raymirabel/ArduPLC/ArduPLCm/README.md

# ArduPLCm #
### Pequeño dispositivo basado en Arduino pensado para sistemas de control y entornos industriales ###

----------

ArduPLCm es un dispositivo microcontrolador que nos ofrece la posibilidad de conectar y controlar dispositivos eléctricos o electrónicos directamente sin necesidad de componentes adicionales. Básicamente es un Arduino con posibilidad real de control.

Gracias a su puerto RS485, está recomendado para aplicaciones distribuidas como domótica, conexión con PLCs industriales, control, etc.

Todas las entradas y salidas son accesibles a través de robustas bornas de tornillo.

ArduPLCm se entrega montado en una caja estándar para carril DIN. Esto nos facilita el montaje dentro de cuadros eléctricos para automatización, domótica, etc.

Para que no pierdas tiempo, hemos incluido en la sección de descargas un nuevo skech que **convierte a tu ArduPLCm en esclavo Modbus RTU**.

**Optiboot_ArduPLCm** es un bootloader de optiboot modificado para ArduPLCm. Este bootloader evita estados indeseados en las salidas de reles cuando ArduPLCm se alimenta.

Características:

- Microcontrolador Atmel ATmega328.
- 4 relés de salida.
- 4 entradas digitales.
- 4 entradas analógicas.
- Dipswitch 6 posiciones.
- Puerto de comunicaciones RS485.
- Programación por ICSP o conector serie TTL.
- Amplio rango de alimentación de6.5 a30 voltios.
- Regulador conmutado.
- Compatible con Arduino.
- Caja para carril DIN.

Especificaciones técnicas:

- Rango de alimentación: 6.5 a30 VDC
- Protección de alimentación: inversión de polaridad
- Protecciones de sobretensión en: entradas analógicas y puerto RS485
- Consumo a 24VDC en reposo: 10mA (0.24W)
- Consumo a 24VDC máximo: 80mA (1.92W)
- Rango entradas analógicas: 0 a 5 VDC
- Rango entradas digitales: 0 a 5VDC
- Máxima corriente salidas relé: 10A
- Máxima tensión salidas relé: 250VAC o 30VDC
- Máxima potencia salidas relé: 2500VA, 300W
- Puerto RS485: No aislado, ¼ unidad de carga, protección ESD +/- 15Kv, control automático de dirección de datos
- Temperatura de funcionamiento: -40 a 85 ºC
- Ancho: 87 mm
- Alto: 90 mm
- Fondo: 58 mm
- Peso: 150 g.
