raymirabel/ArduPLC/ArduPLC V2/Examples/test_ArduPLC_v2_00/Cambiar SS_PIN.txt

Editar el fichero Sd2PinMap.h dentro de la libreria SD/utility
Cambiar:

//------------------------------------------------------------------------------
#else  // defined(__AVR_ATmega1280__) || defined(__AVR_ATmega2560__)
// 168 and 328 Arduinos

// Two Wire (aka I2C) ports
uint8_t const SDA_PIN = 18;
uint8_t const SCL_PIN = 19;

// SPI port
//uint8_t const SS_PIN = 10;
uint8_t const SS_PIN = 2;
uint8_t const MOSI_PIN = 11;
uint8_t const MISO_PIN = 12;
uint8_t const SCK_PIN = 13;
