raymirabel/ArduPLC/ArduPLC V2/ArduPLC V2 - Schematic.pdf

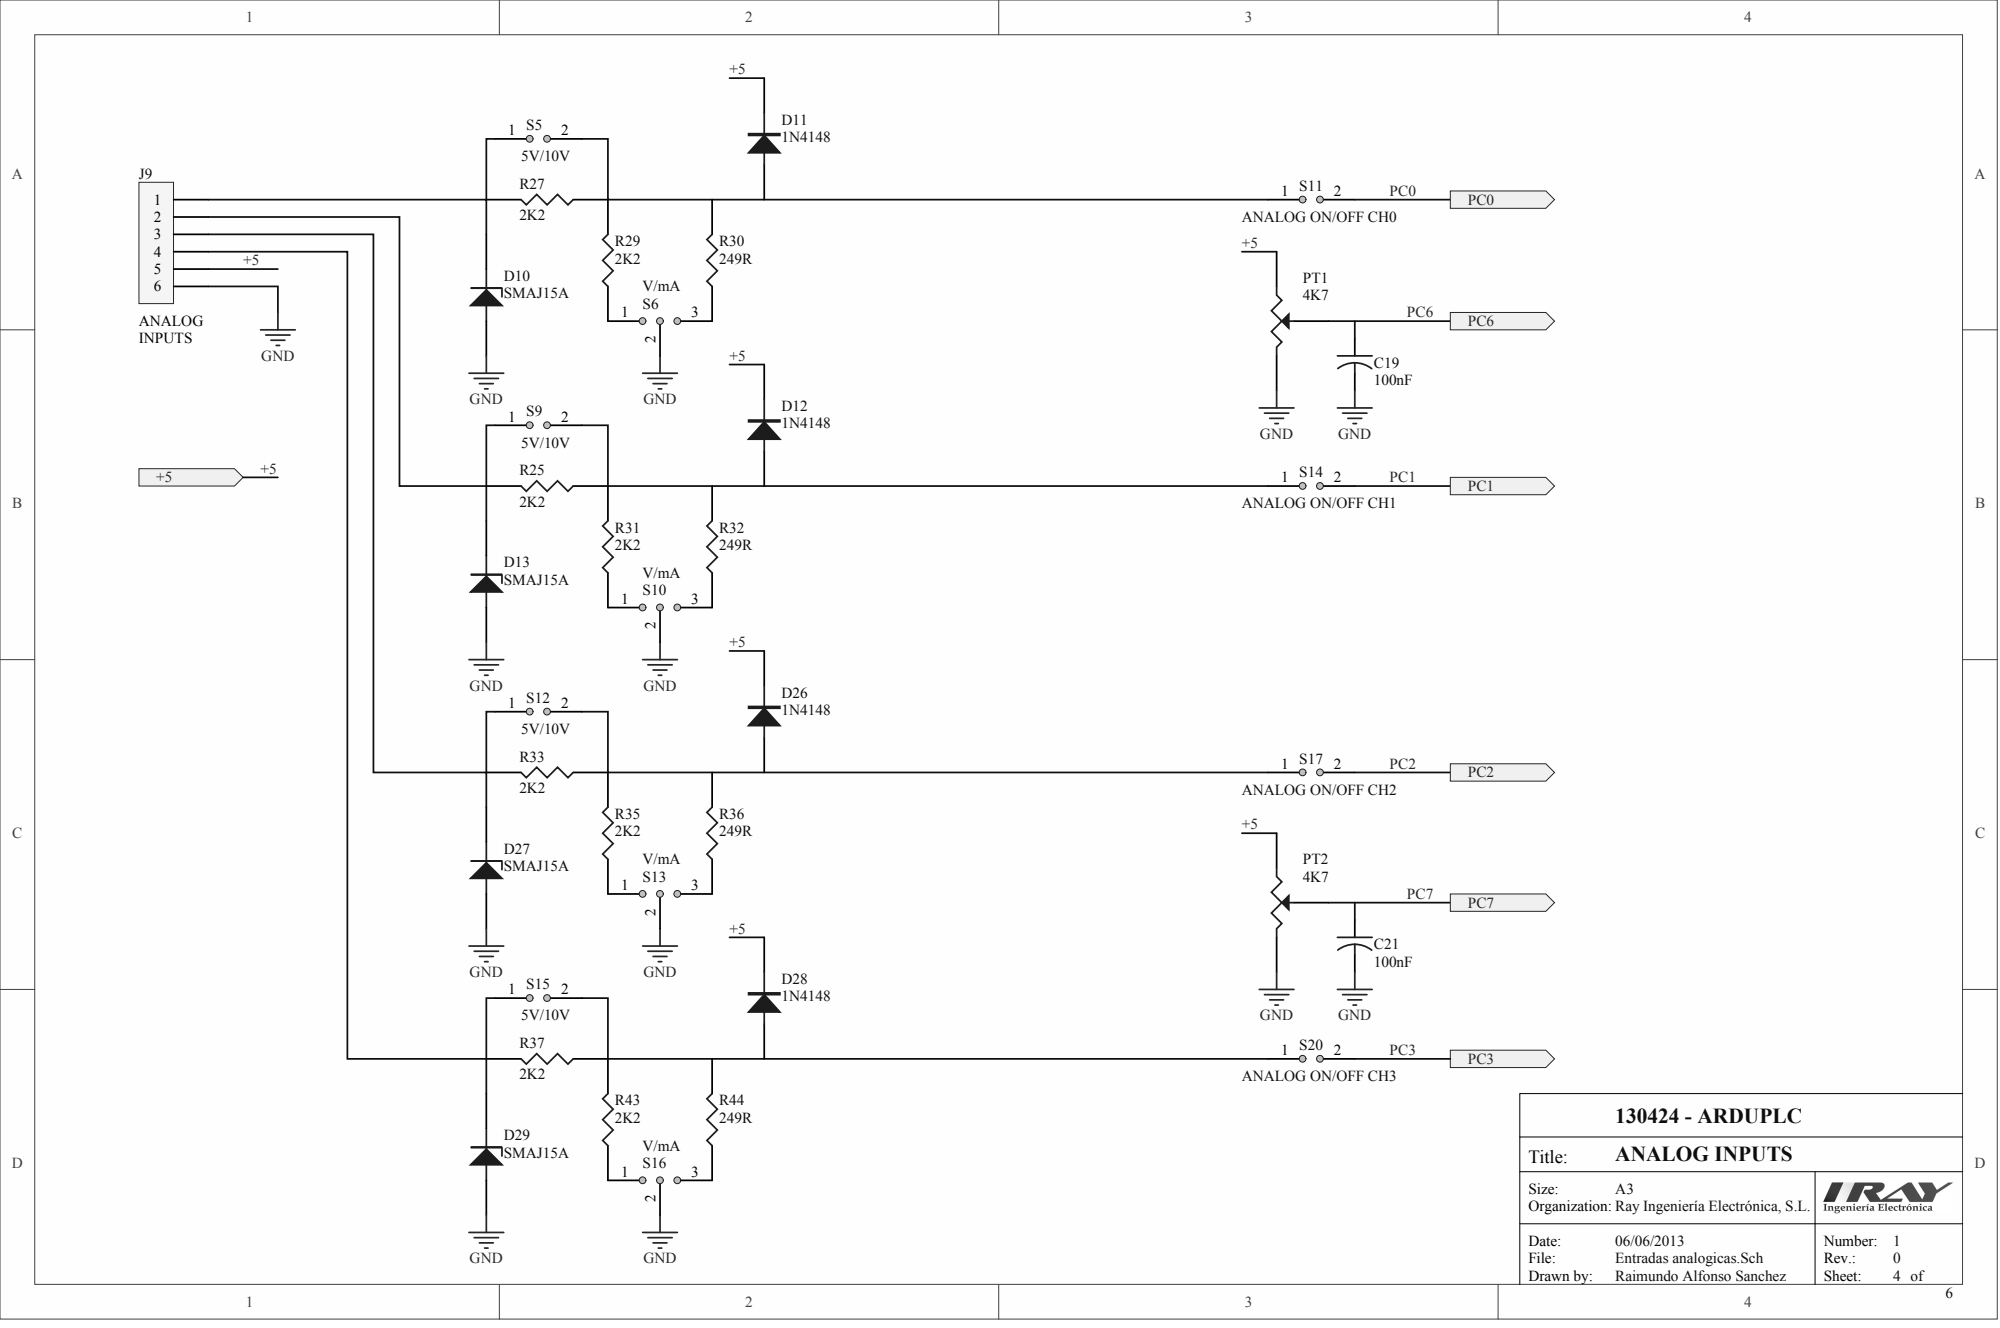
[picture p99: page 1]

P0J903
P0J905 | +5

Size: A3 Organization: Ray Ingeniería Electrónica, S.L .

Date: File: 06/06/2013 Entradas analogicas.Sch Drawn by : Raimundo Alfonso Sanchez | Number: 41 Rev.: 0 Sheet: of

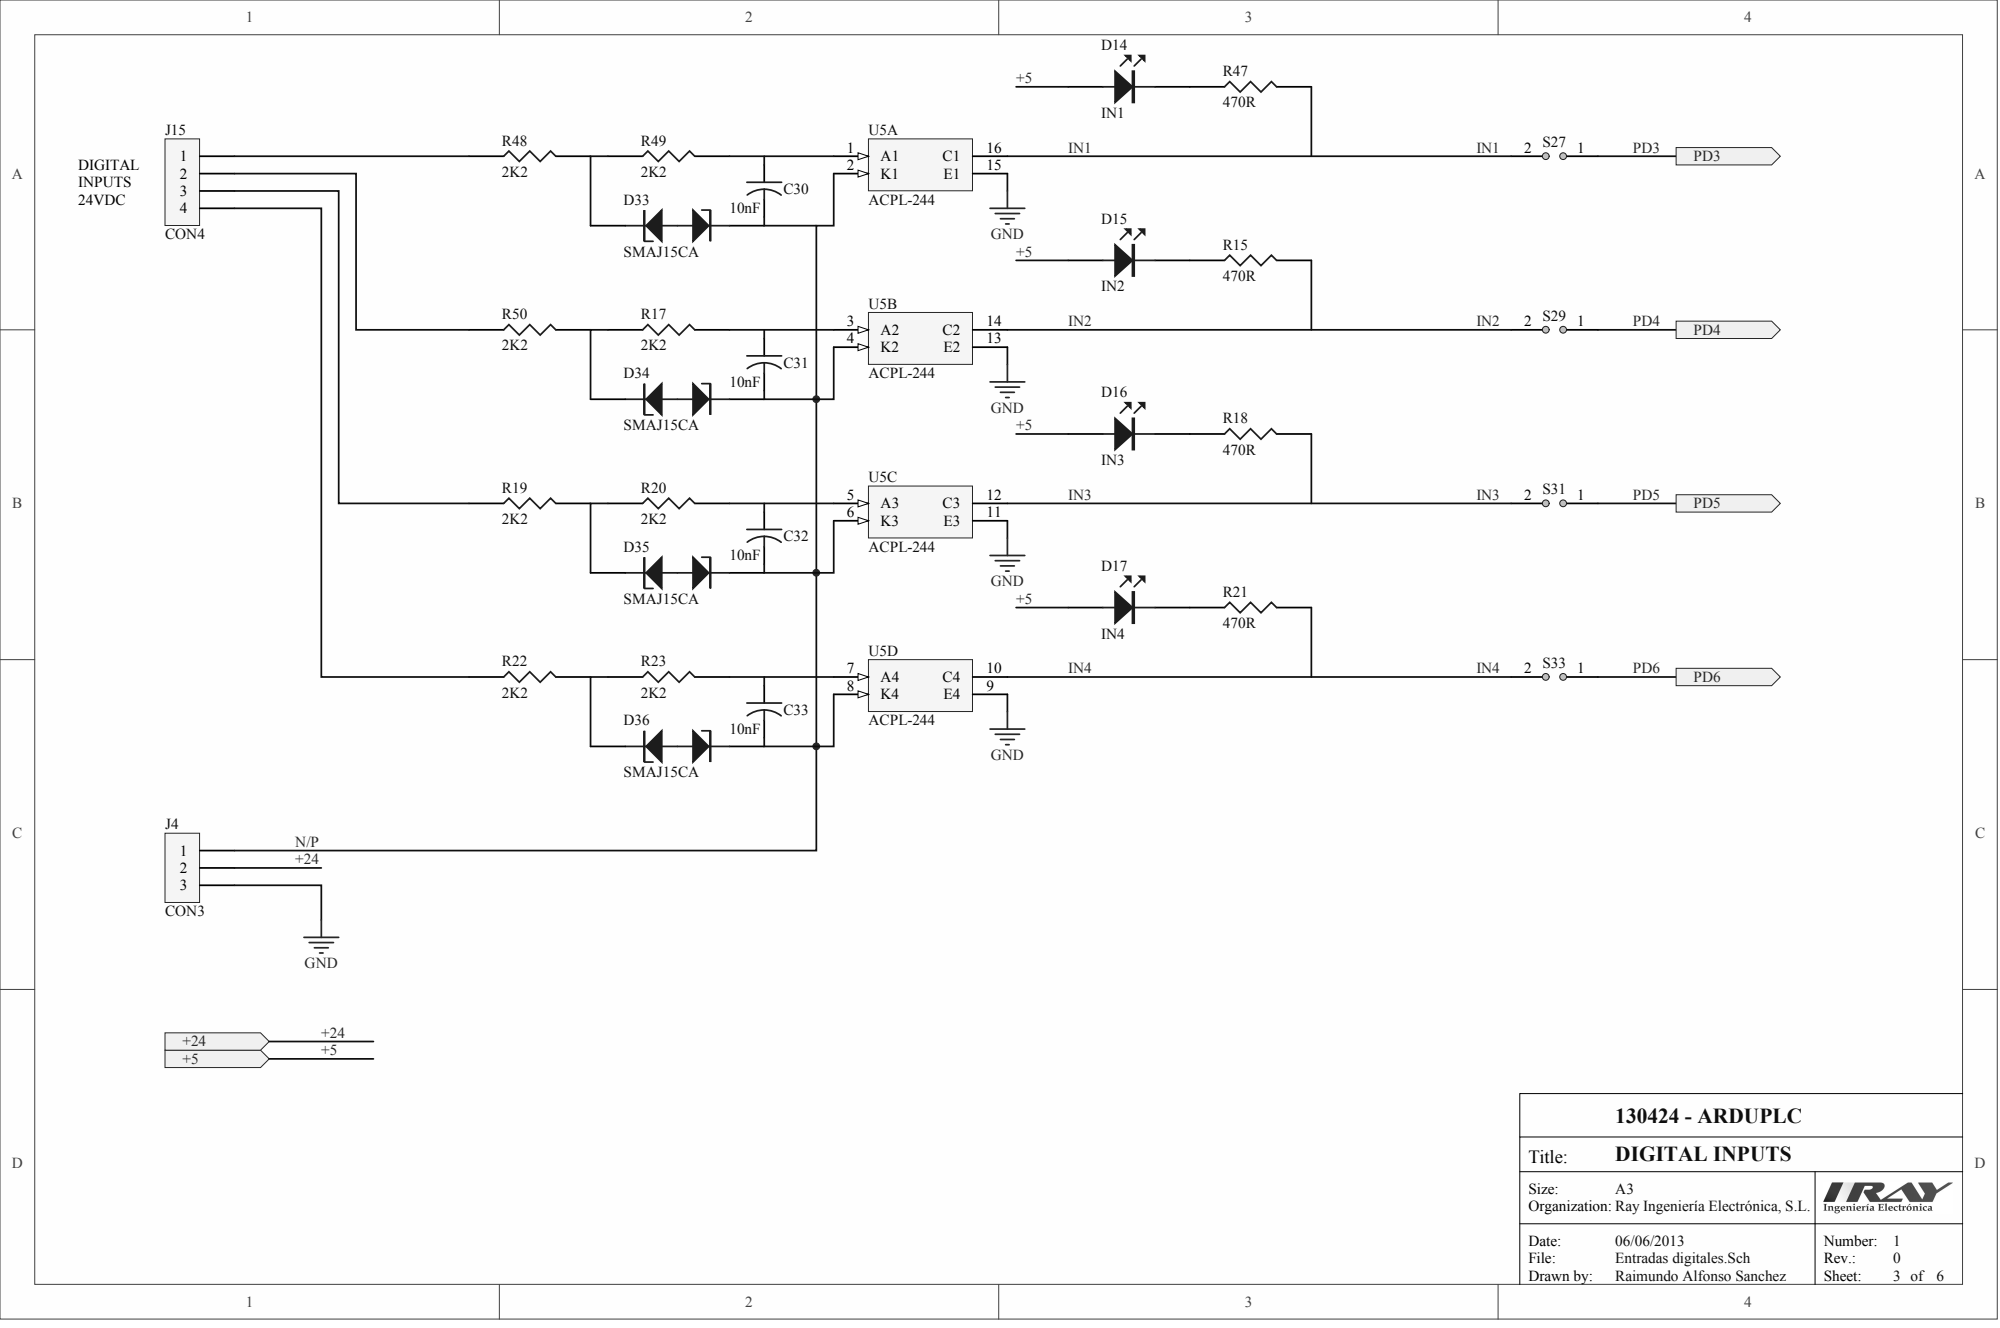
[picture p100: page 2]

Size: A3 Organization: Ray Ingeniería Electrónica, S.L .

Date: File: 06/06/2013 Entradas digitales.Sch Drawn by : Raimundo Alfonso Sanchez | Number: 1 Rev.: 03 Sheet: of 6

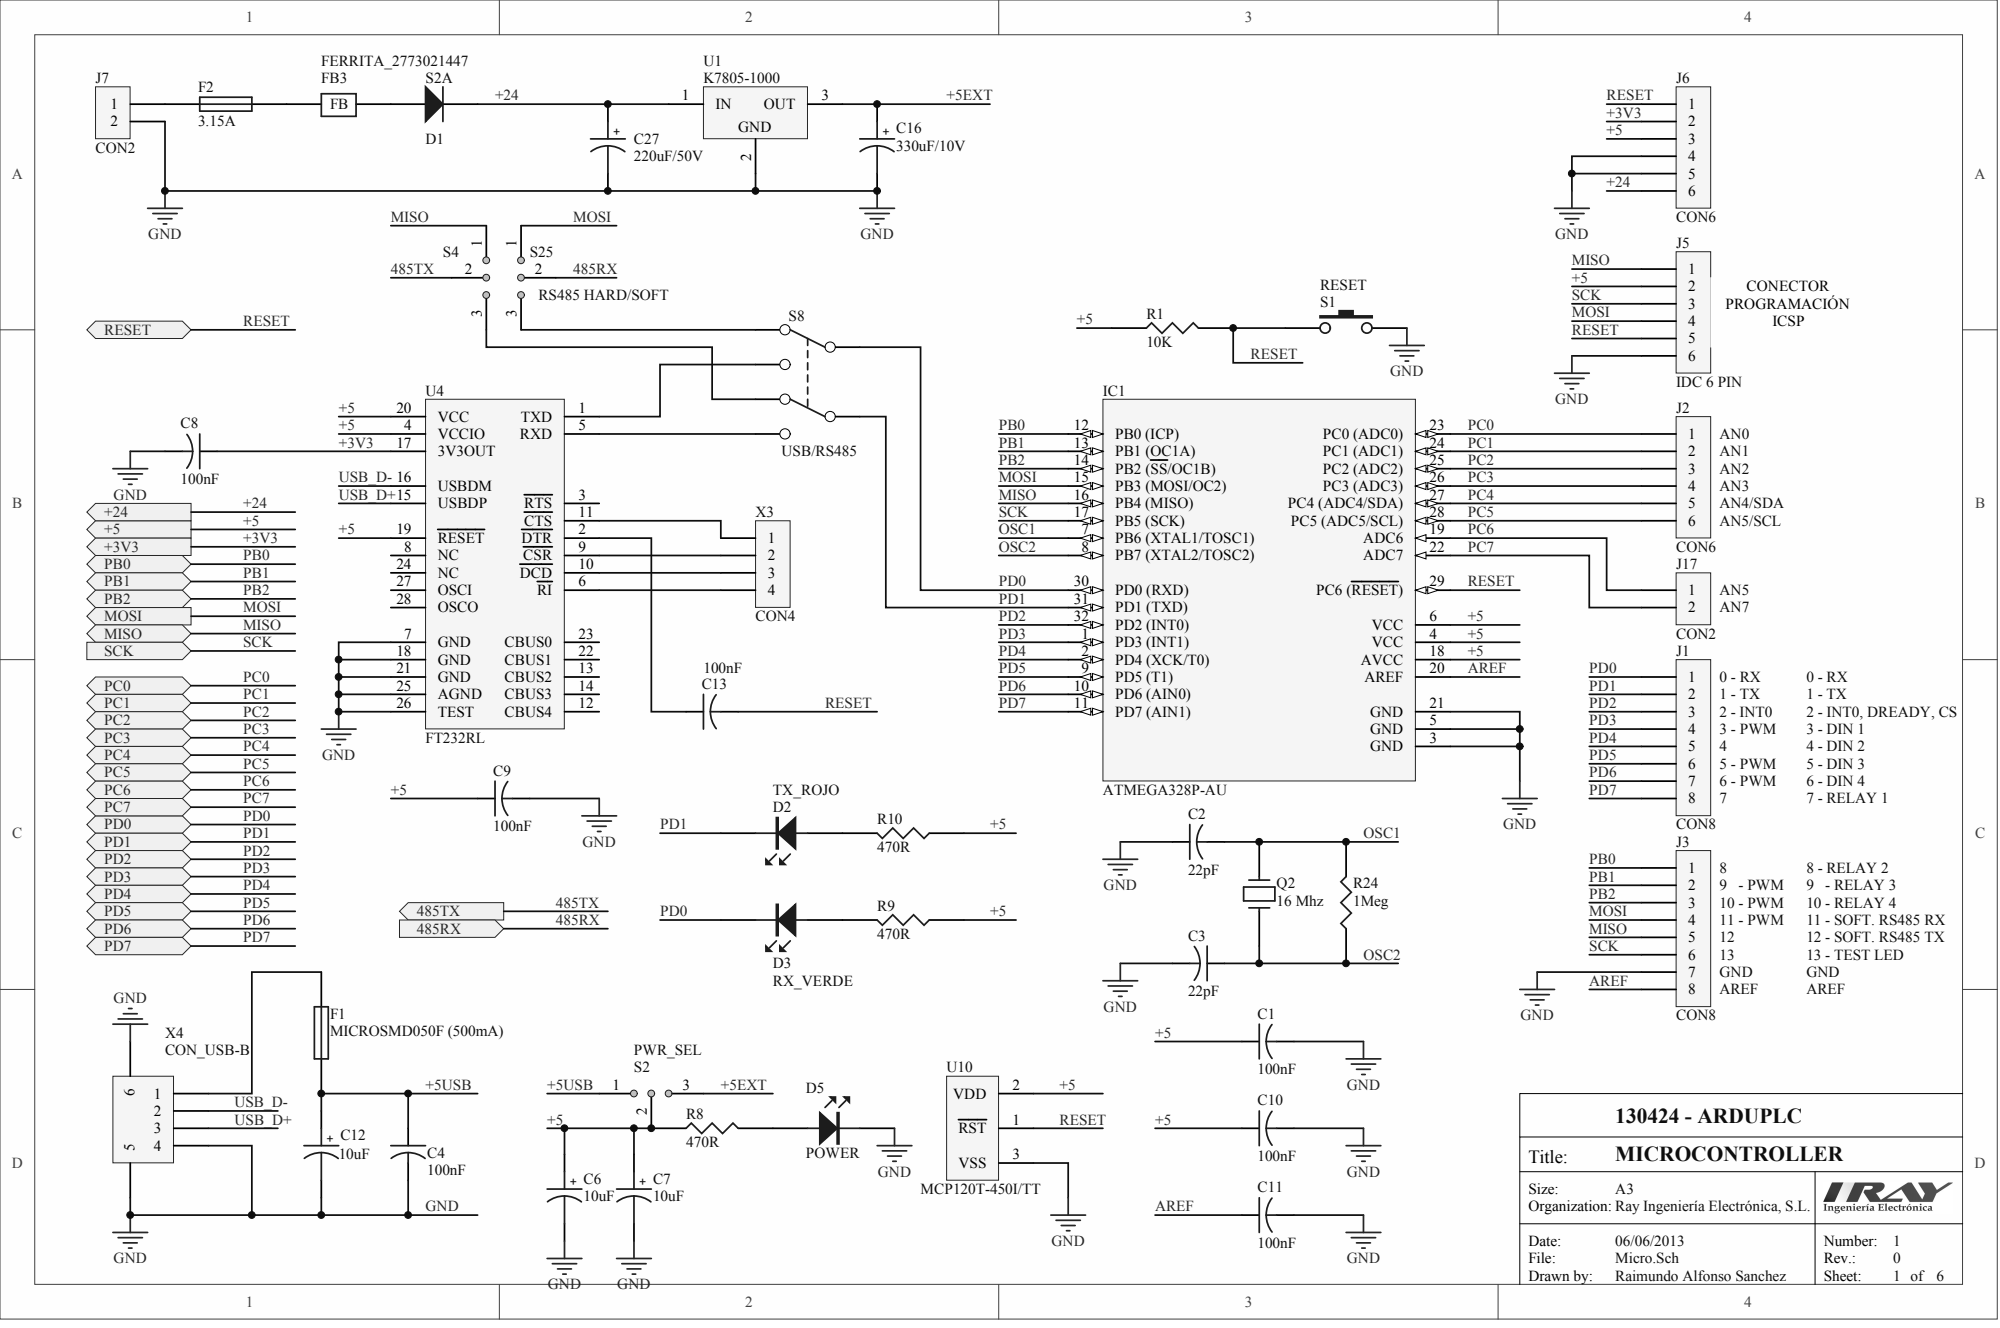
[picture p101: page 3]

Size: A3 Organization: Ray Ingeniería Electrónica, S.L .

Date: File: 06/06/2013 Micro.Sch Drawn by : Raimundo Alfonso Sanchez | Number: 1 Rev.: 01 Sheet: of 6

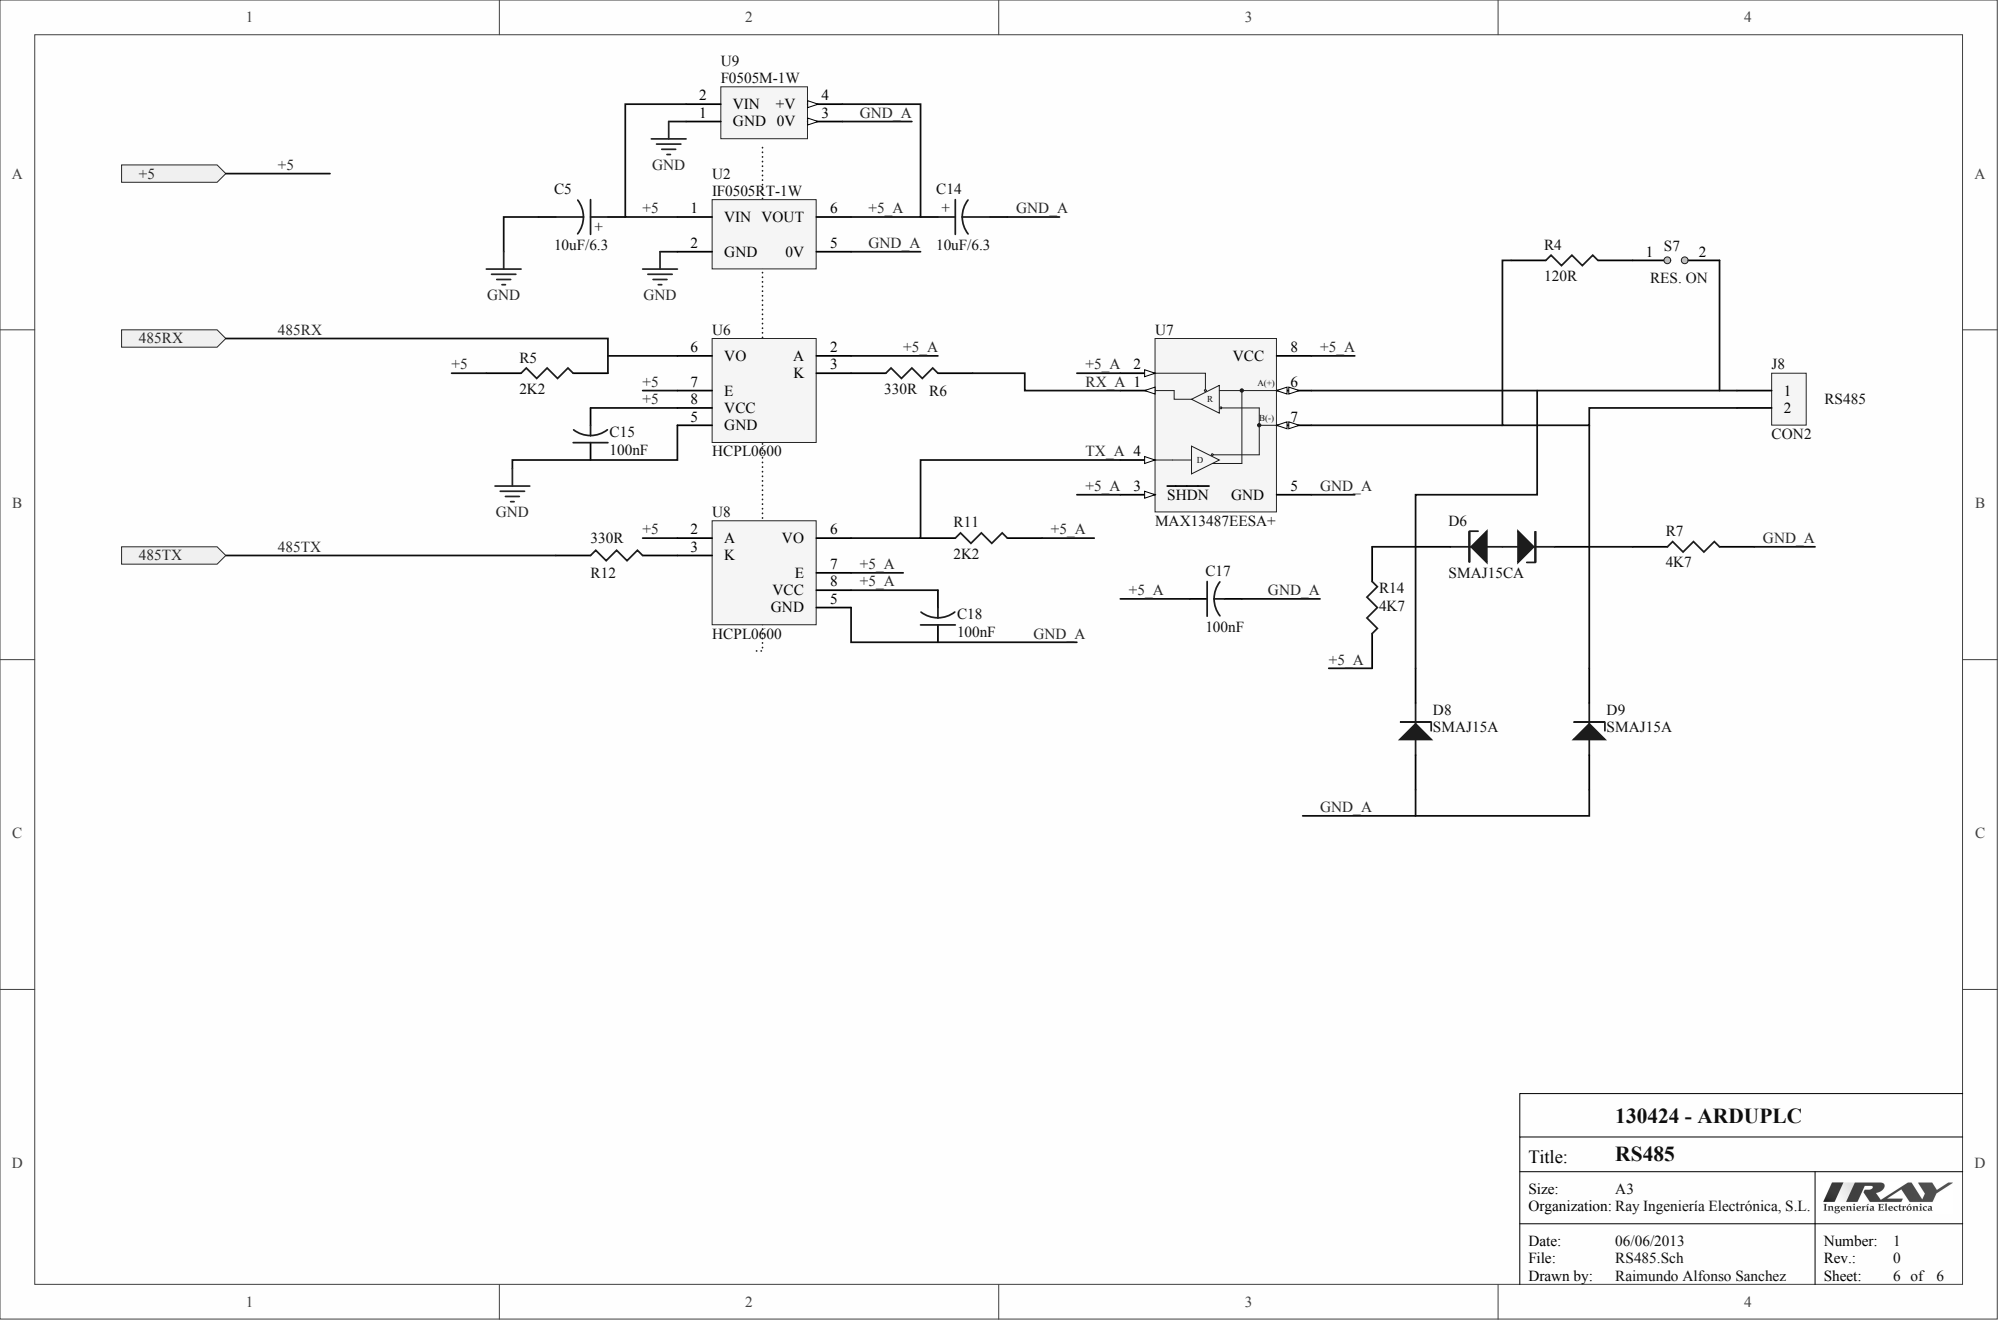
[picture p102: page 4]

Size: A3 Organization: Ray Ingeniería Electrónica, S.L.

Date: 06/06/2013 File: RS485.Sch Drawn by: Raimundo Alfonso Sanchez | Number: 1 Rev.: 0 Sheet: 6 of 6

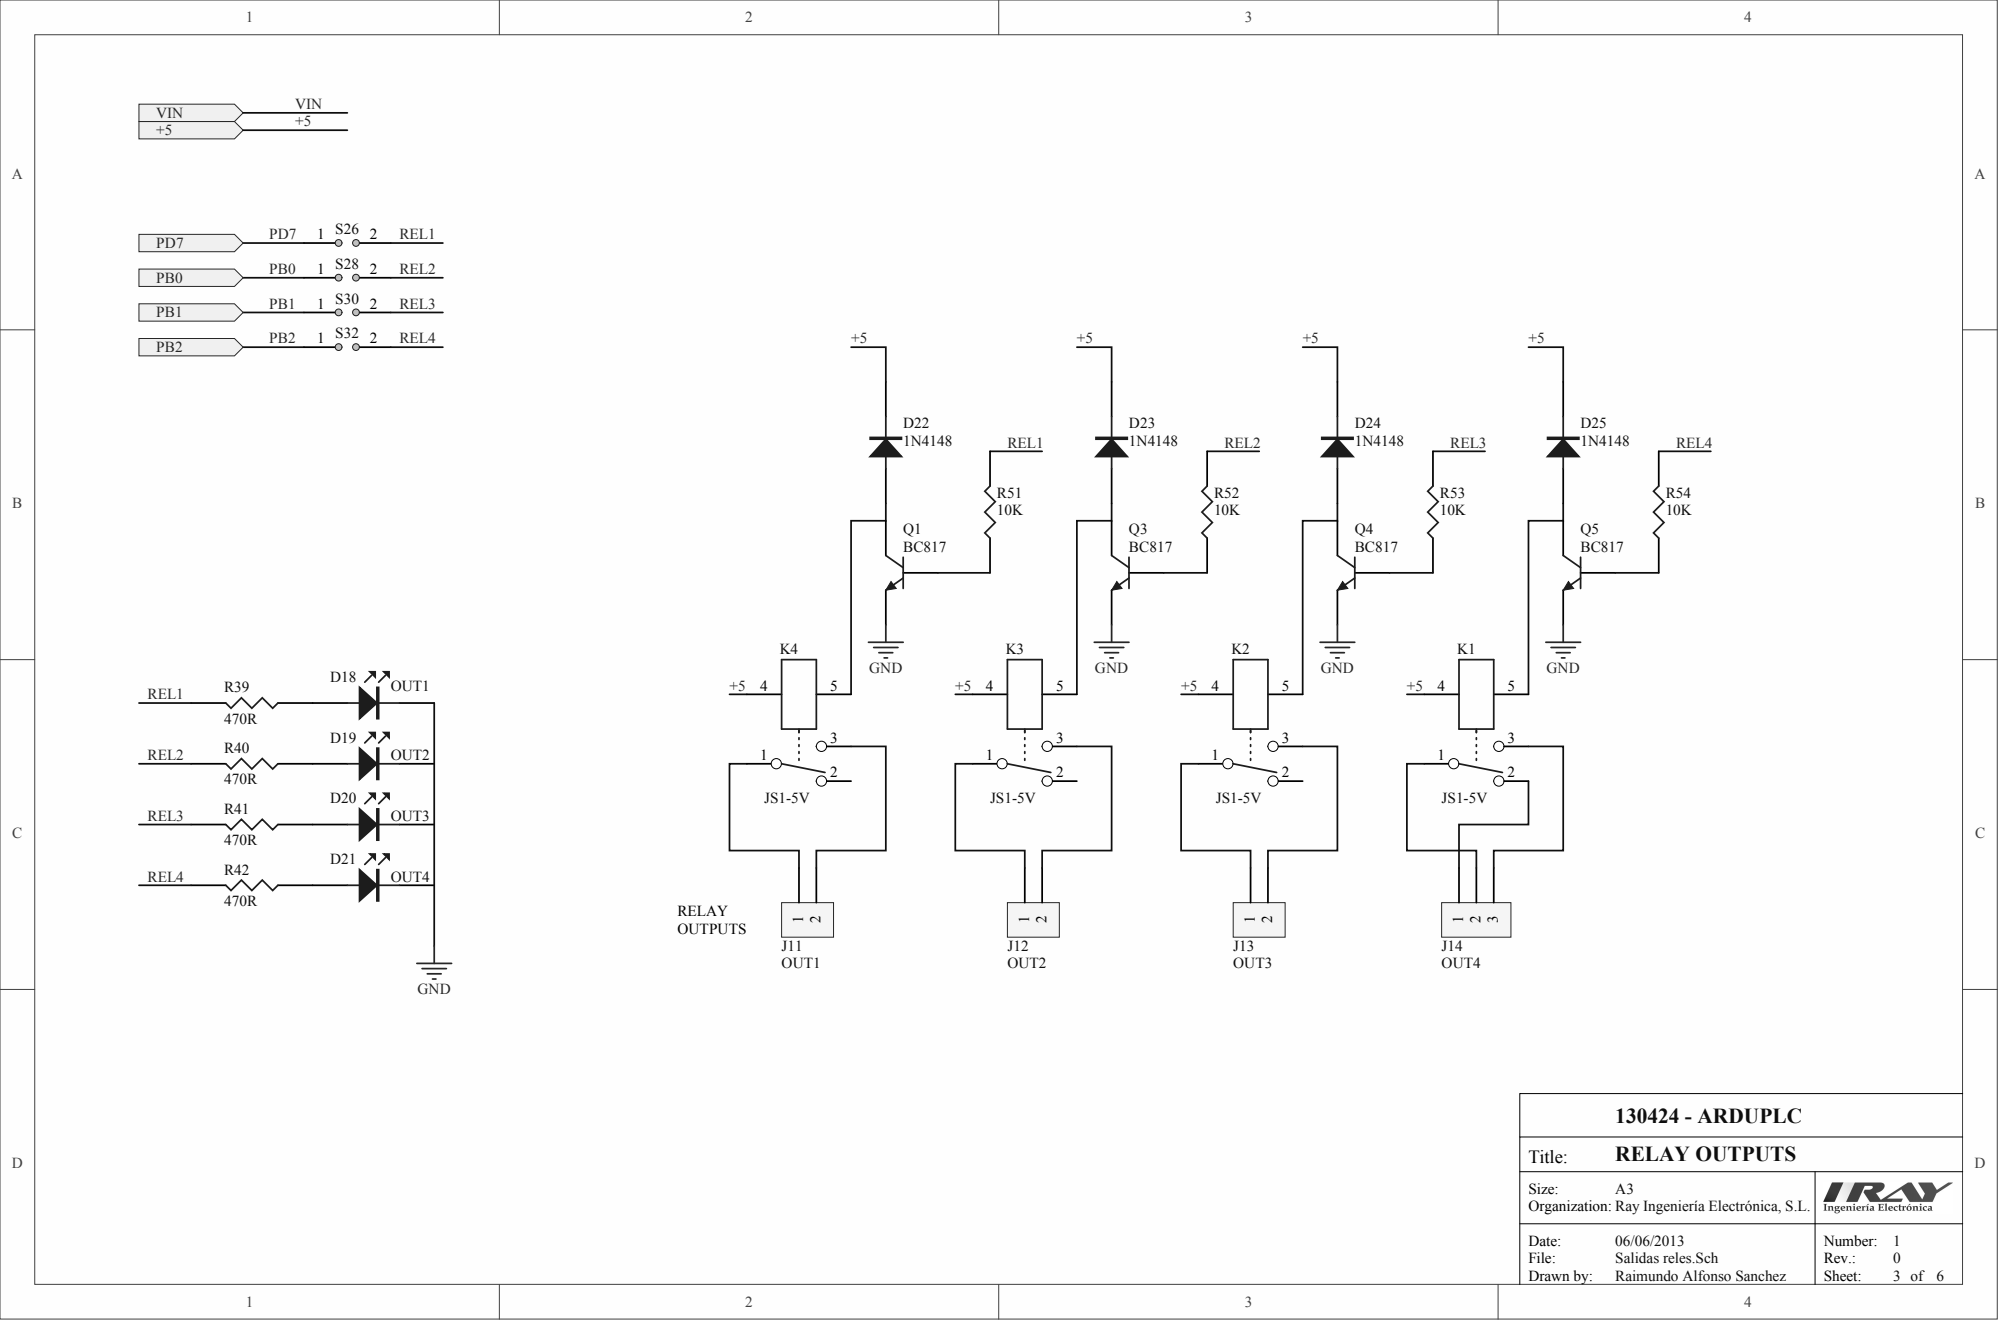
[picture p103: page 5]

Size: A3 Organization: Ray Ingeniería Electrónica, S.L .

Date: File: 06/06/2013 Salidas reles.Sch Drawn by : Raimundo Alfonso Sanchez | Number: 1 Rev.: 03 Sheet: of 6

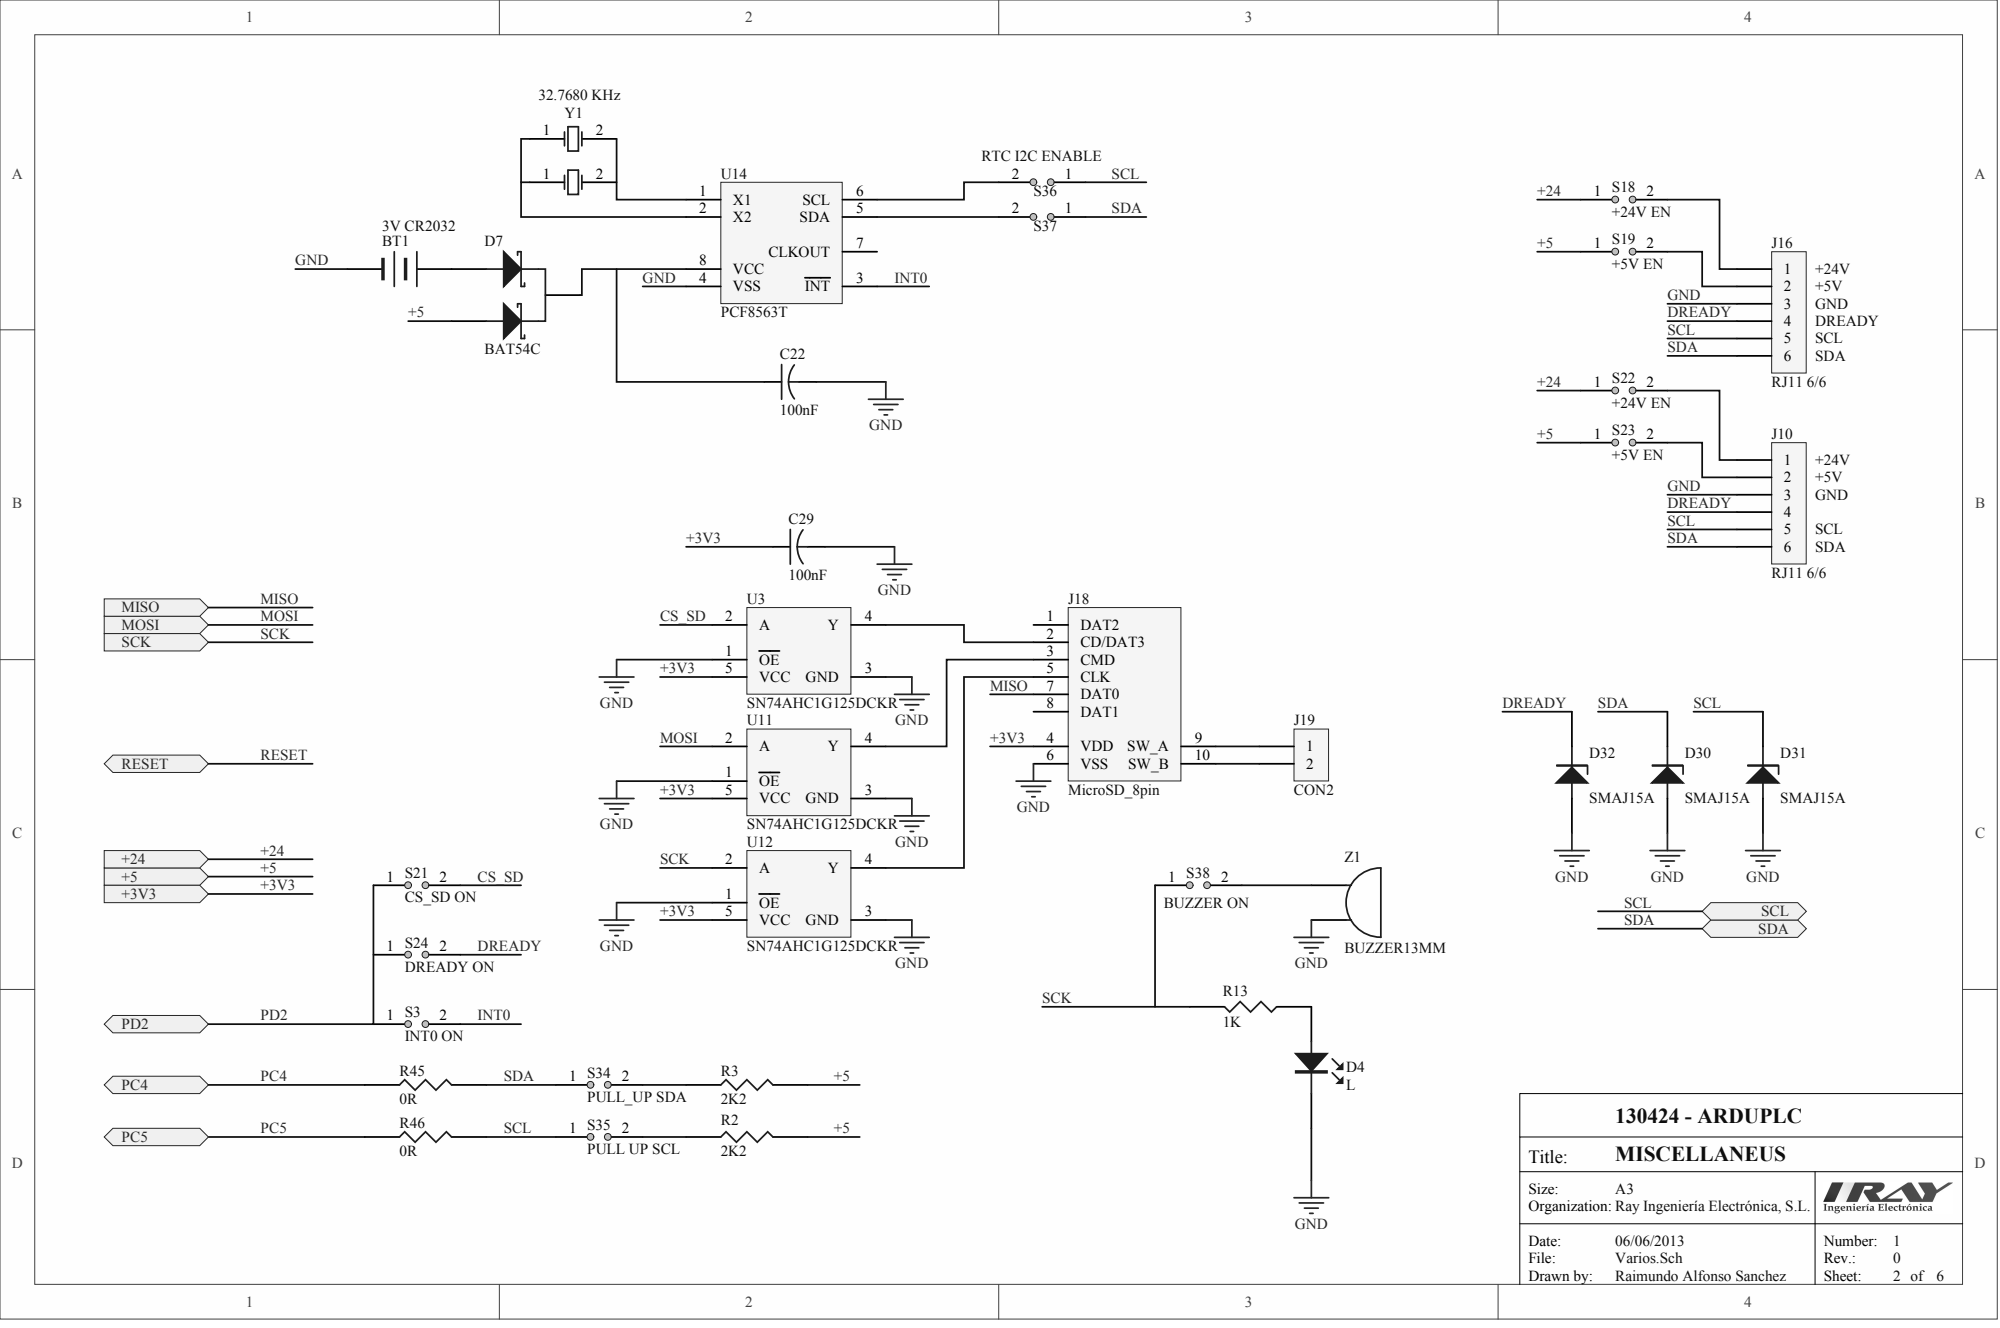
[picture p104: page 6]

CD/DAT3 2
CMD 3
CLK 5

+3V3 | DAT0 7 DAT1 8

Size: A3 Organization: Ray Ingeniería Electrónica, S.L.

Date: 06/06/2013 File: Varios.Sch Drawn by: Raimundo Alfonso Sanchez | Number: 1 Rev.: 0 Sheet: 2 of 6
