raymirabel/ArduPLC/ArduPLC MICRO/ArduPLC MICRO - SCHEMATIC.pdf

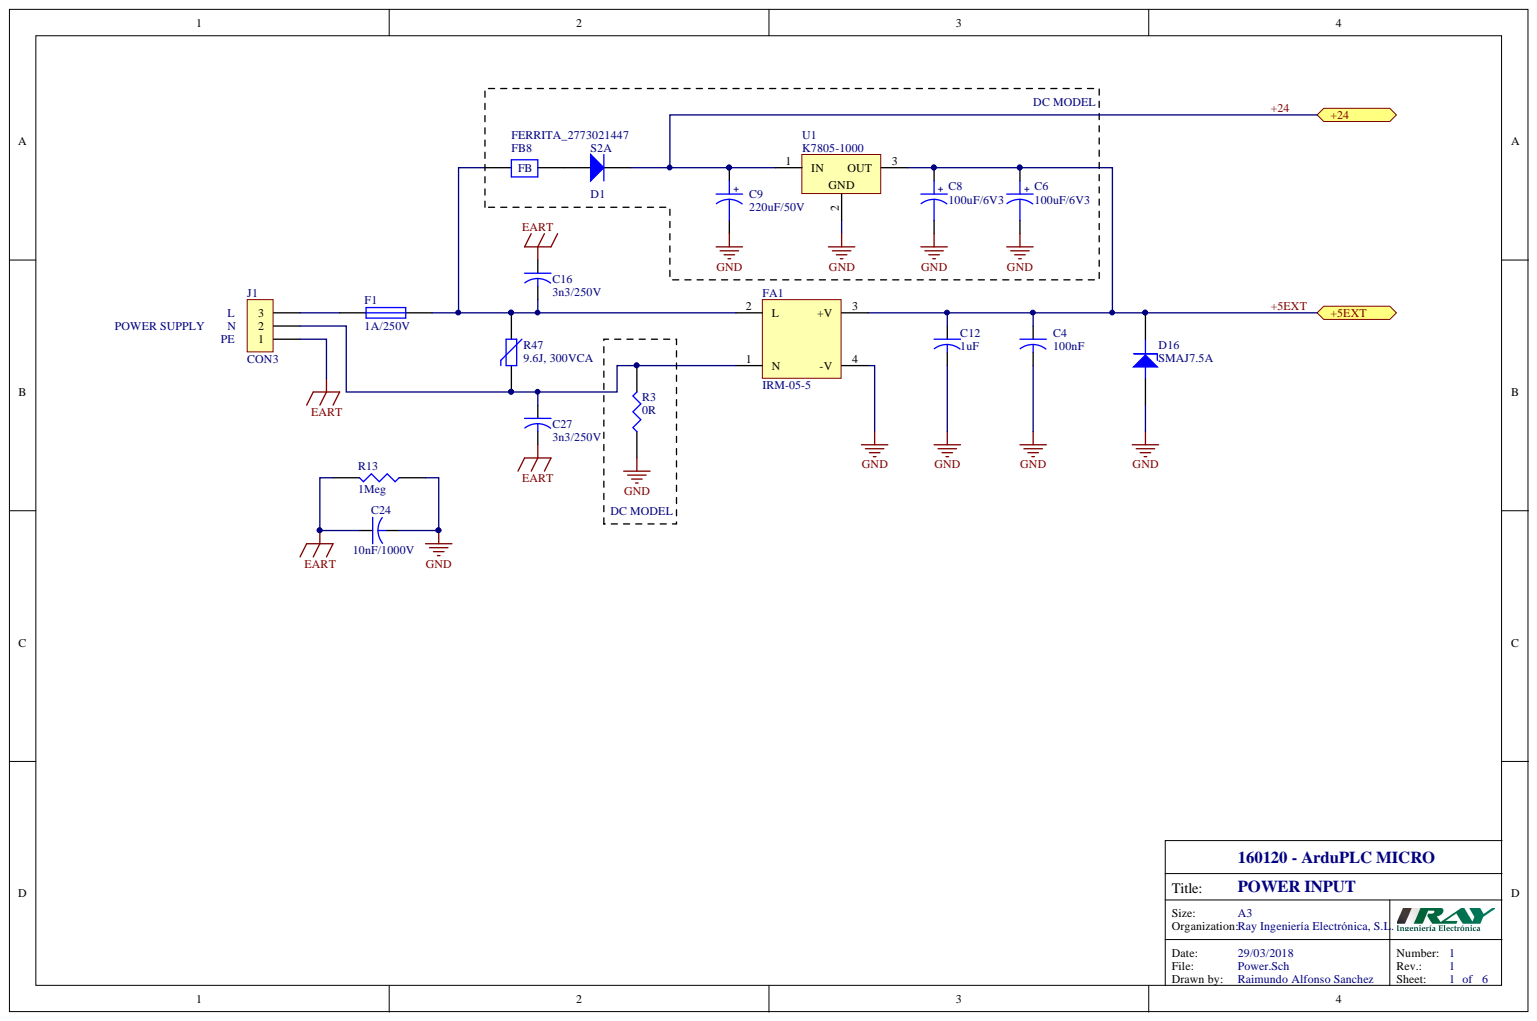
[picture p105: page 1]

Size: A3 Organization: Ray Ingeniería Electrónica, S.L.

Date: 29/03/2018 File: Power.Sch Drawn by: Raimundo Alfonso Sanchez | Number: 1 Rev.: Sheet: of

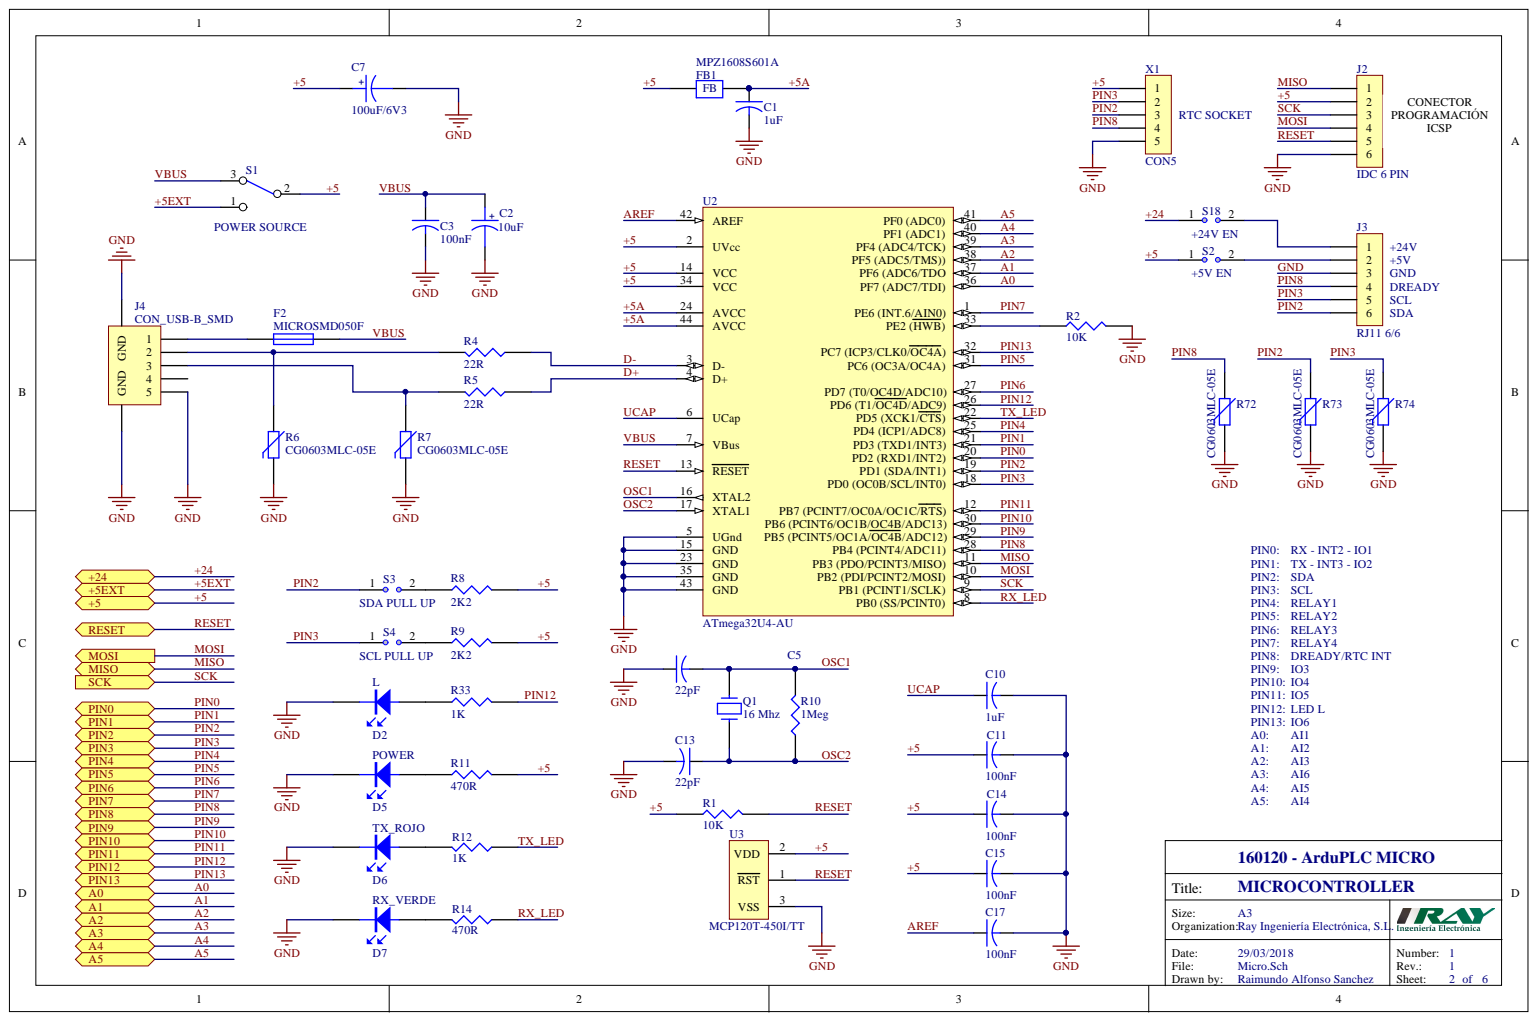
[picture p106: page 2]

1 5
2 3
3 5
4 3

Size: A 3 Organ izat i o n : Ray In gen ier ía E lect r ó n ica, S.L | .

Date: 2 9 / 0 3 / 2 0 1 8 Fi le: Micro.Sch Draw n b y : Raimu n d o A lfo s o Sanchez | N umber: 1 Sheet : o f

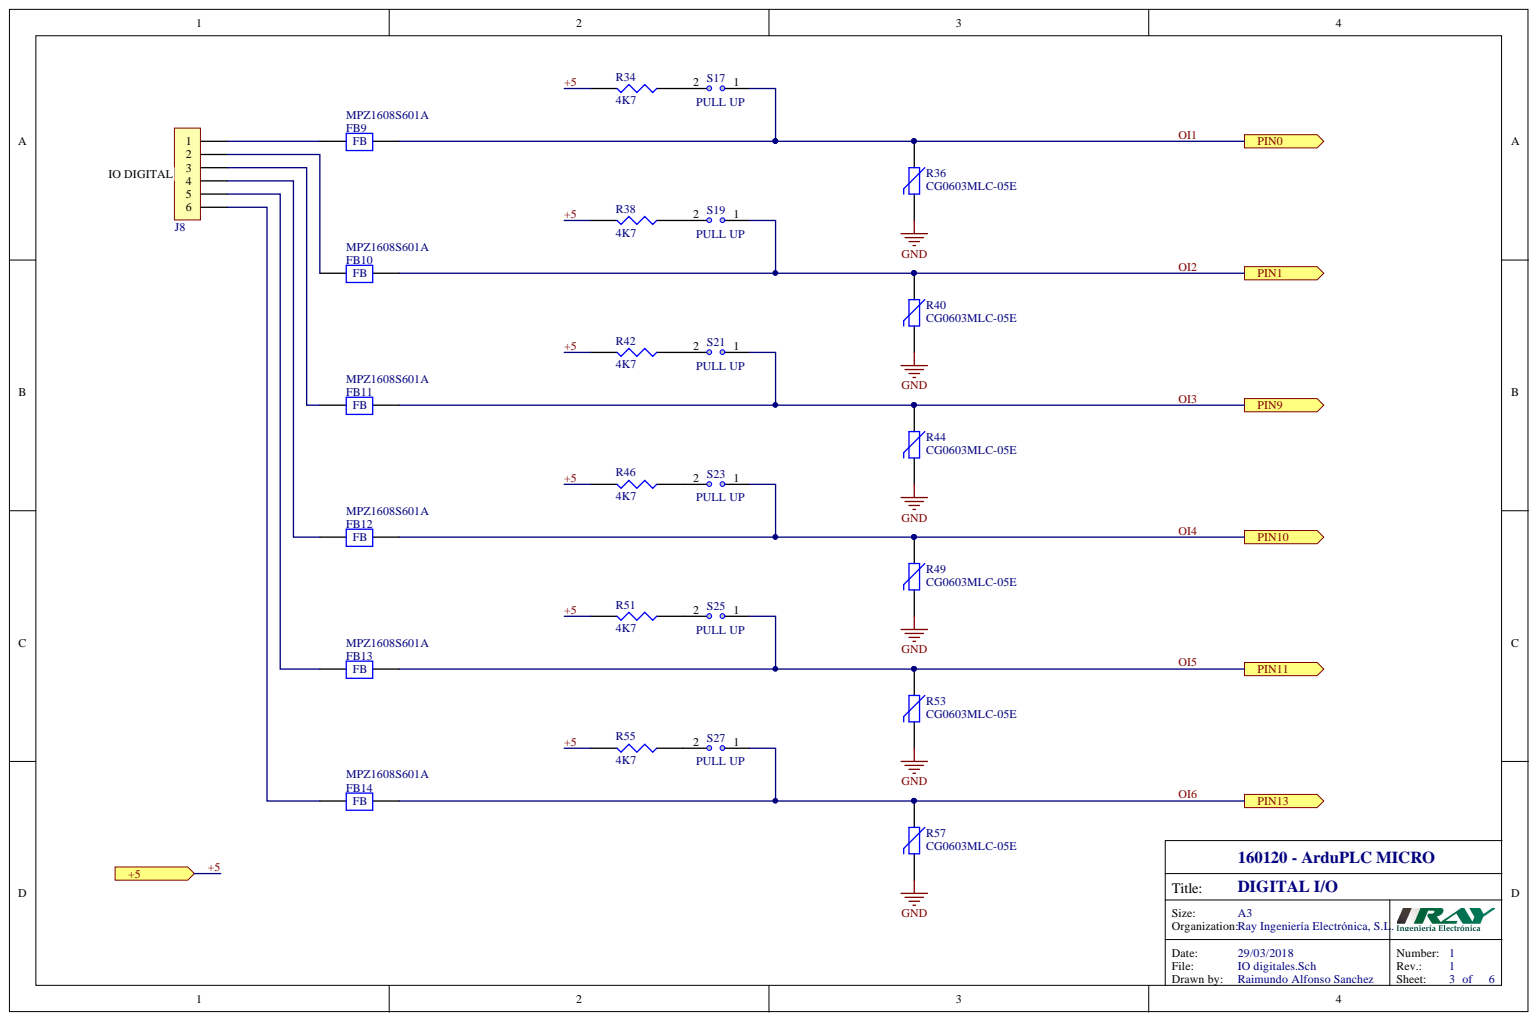
[picture p107: page 3]

Size: A3 Organization: Ray Ingeniería Electrónica, S.L.

Date: 29/03/2018 IO digitales.Sch | Number: 1 1

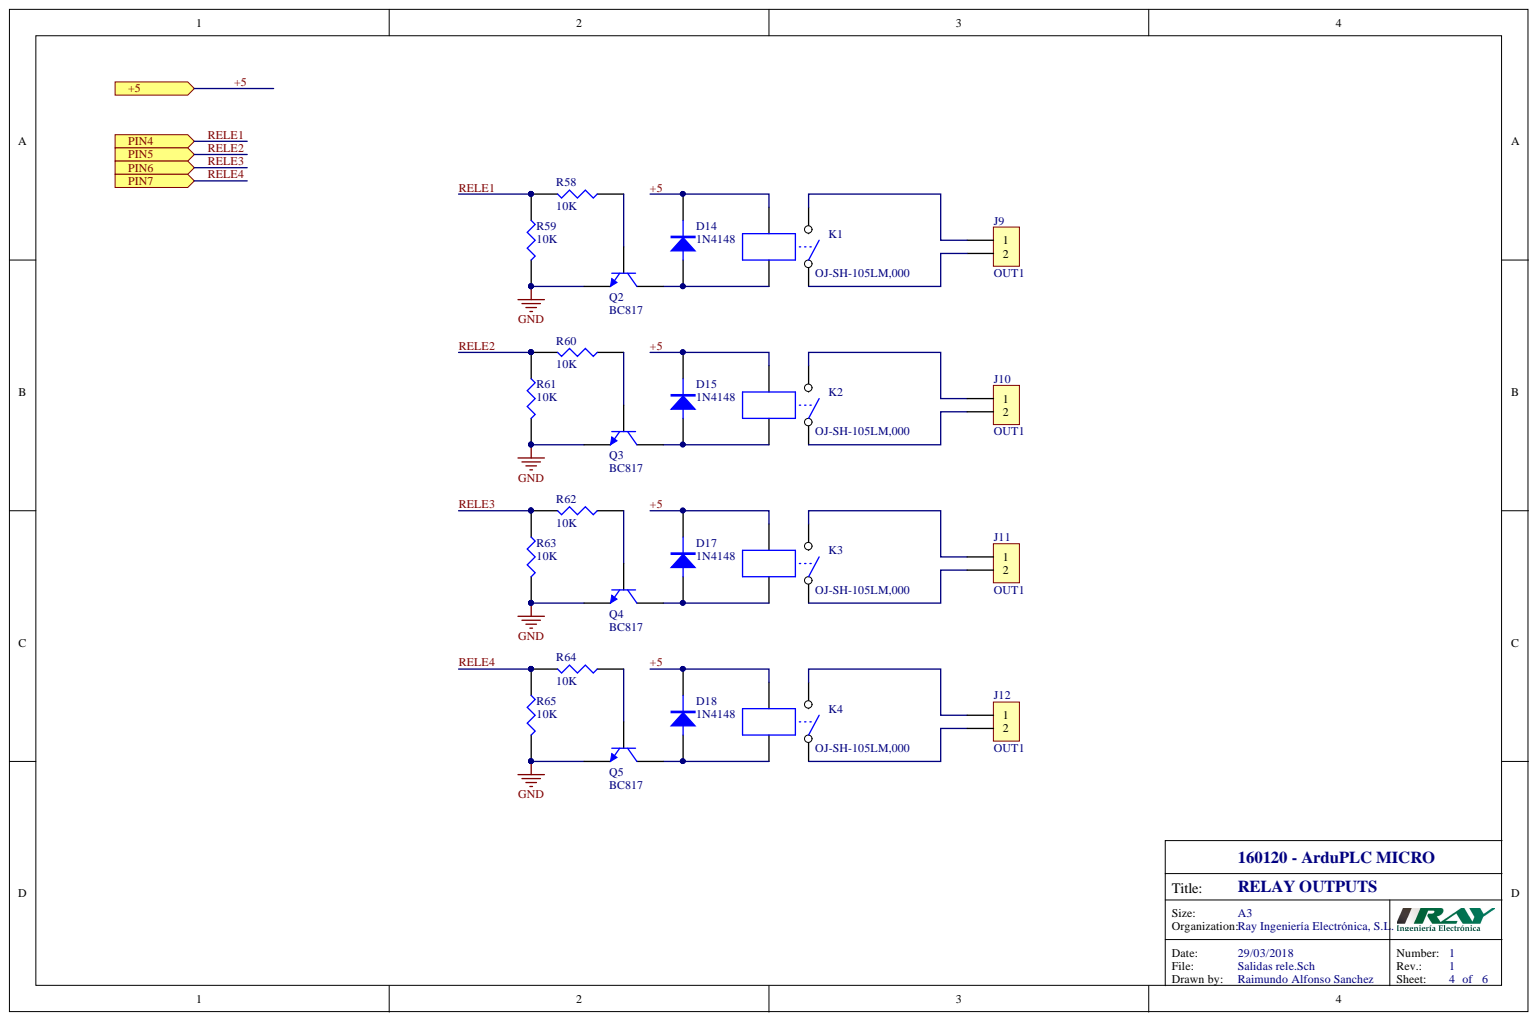
[picture p108: page 4]

Size: A3 Organization: Ray Ingeniería Electrónica, S.L.

Date: 29/03/2018 Salidas rele.Sch | Number: 1 1

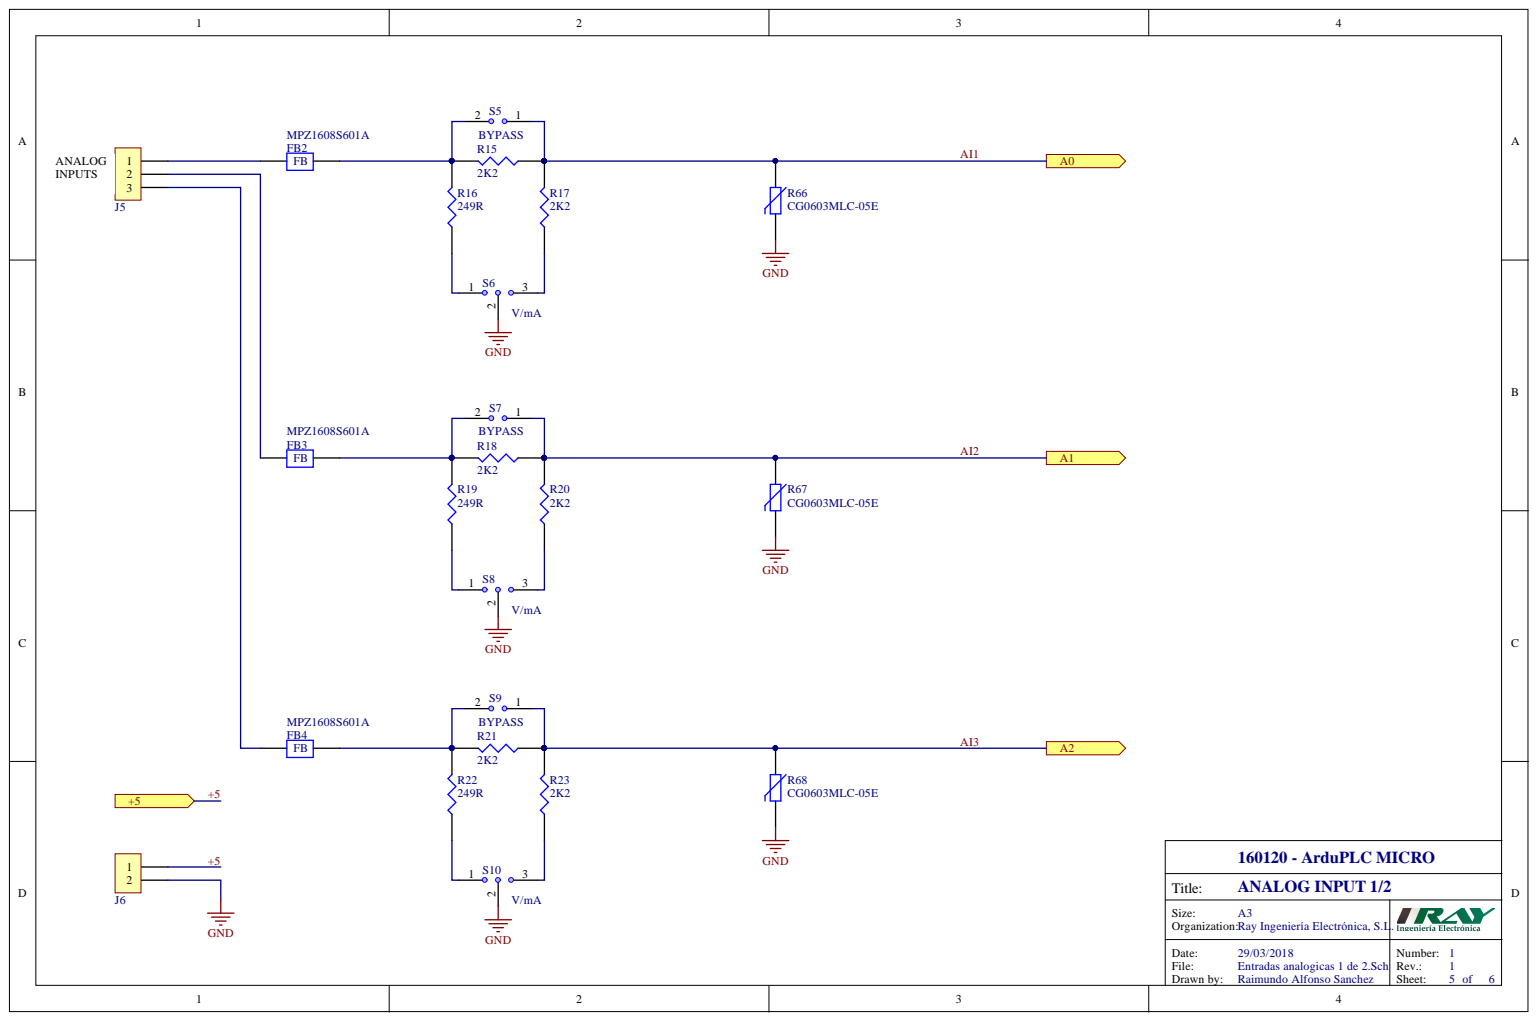
[picture p109: page 5]

Size: A 3 Organ izat i o n : gen ier ía E lect r ó n ica, S.L | .

Date: 2 9 / 0 3 / 2 0 1 8 E tradas anal g icas 1 de 2.Sch | N umber: 1

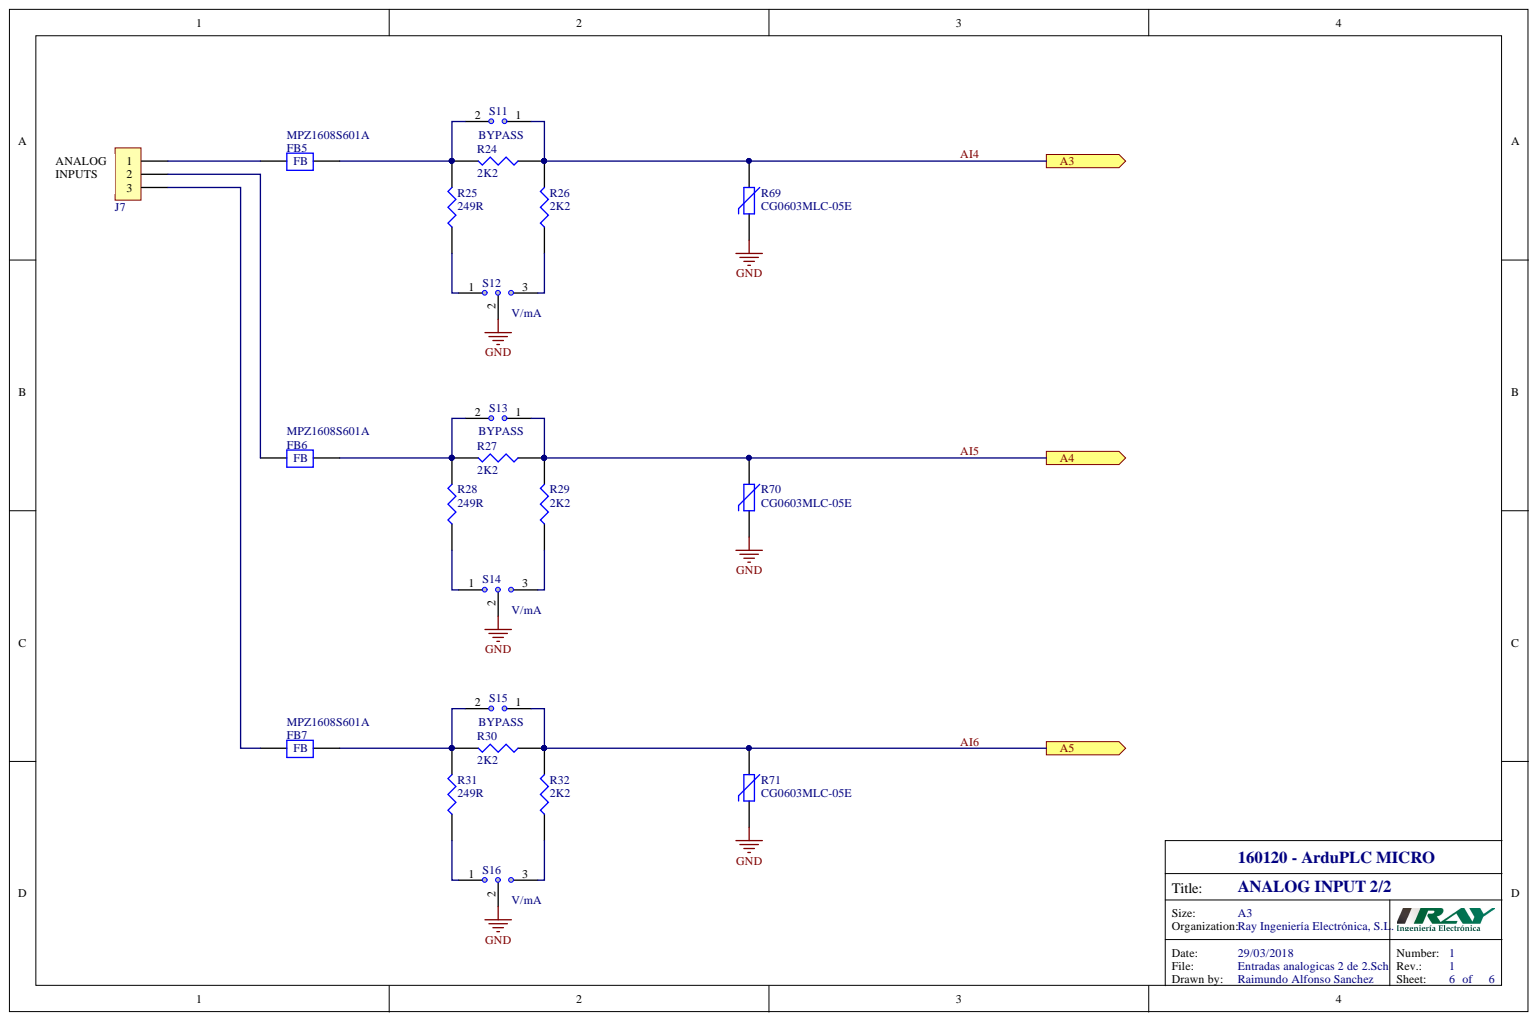
[picture p110: page 6]
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

Date: 2 9 / 0 3 / 2 0 1 8 E tradas anal g icas 2 de 2.Sch | N umber: 1
