raymirabel/ArduPLC/ArduPLC MEGA/ArduPLC MEGA - Schematic.pdf

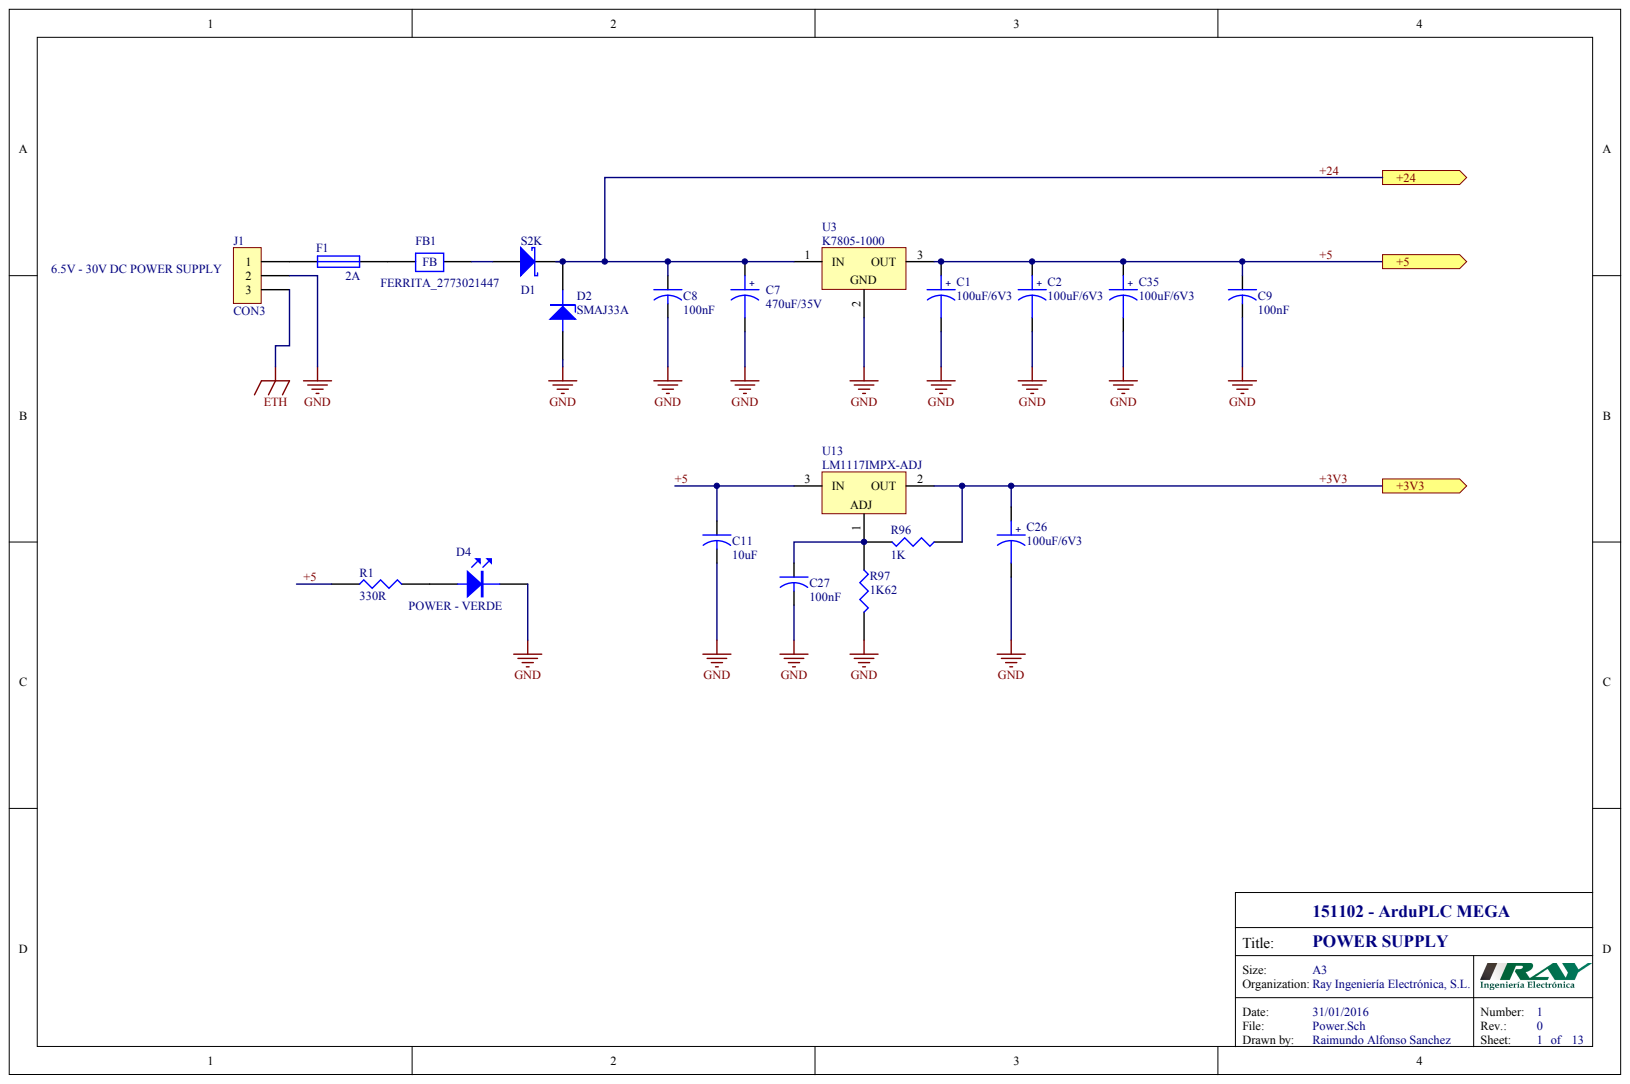
[picture p111: page 1]

Size : A 3 Organiza tion: Ray In g enierí a Electrónica, S.L.

Date: File: 31/01/2016 Power.Sch Drawn by : Raimundo A l fonso Sanche z | Number: 01 13 1 Rev.: Sheet: of

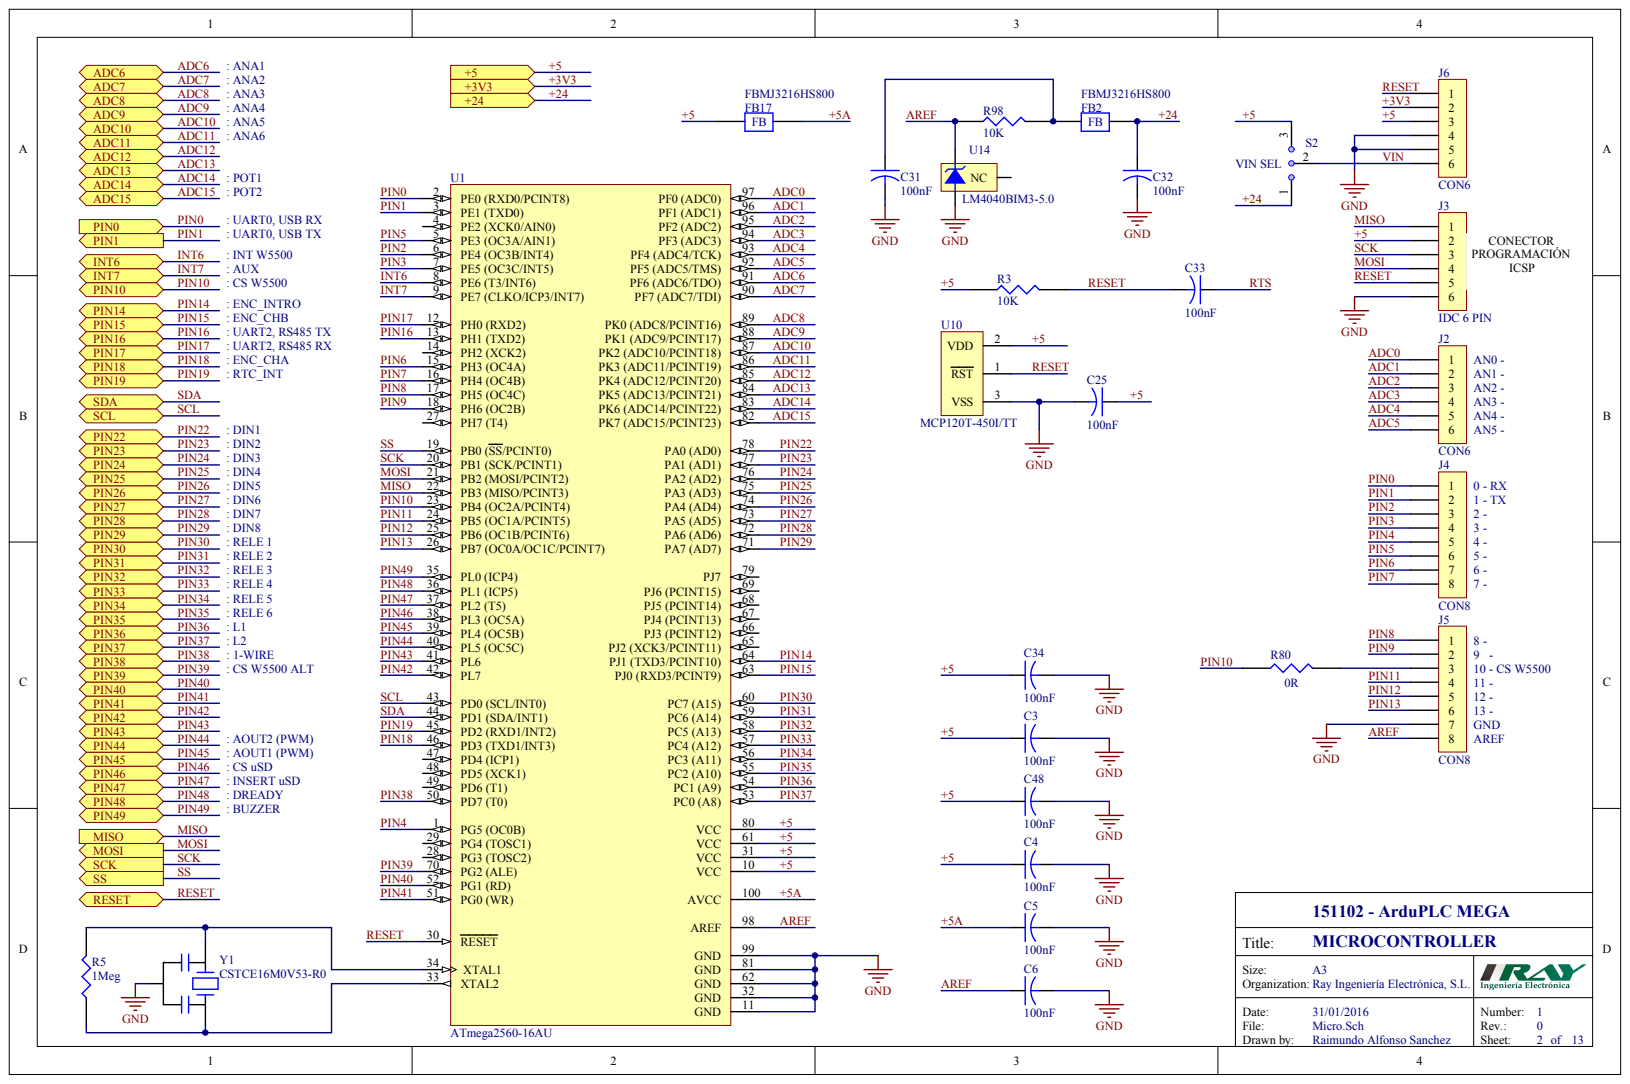
[picture p112: page 2]

Size : A 3 Organiza tion: Ray In g enierí a Electrónica, S.L.

Date: File: 31/01/2016 Micro.Sch | Number: 02 13 1

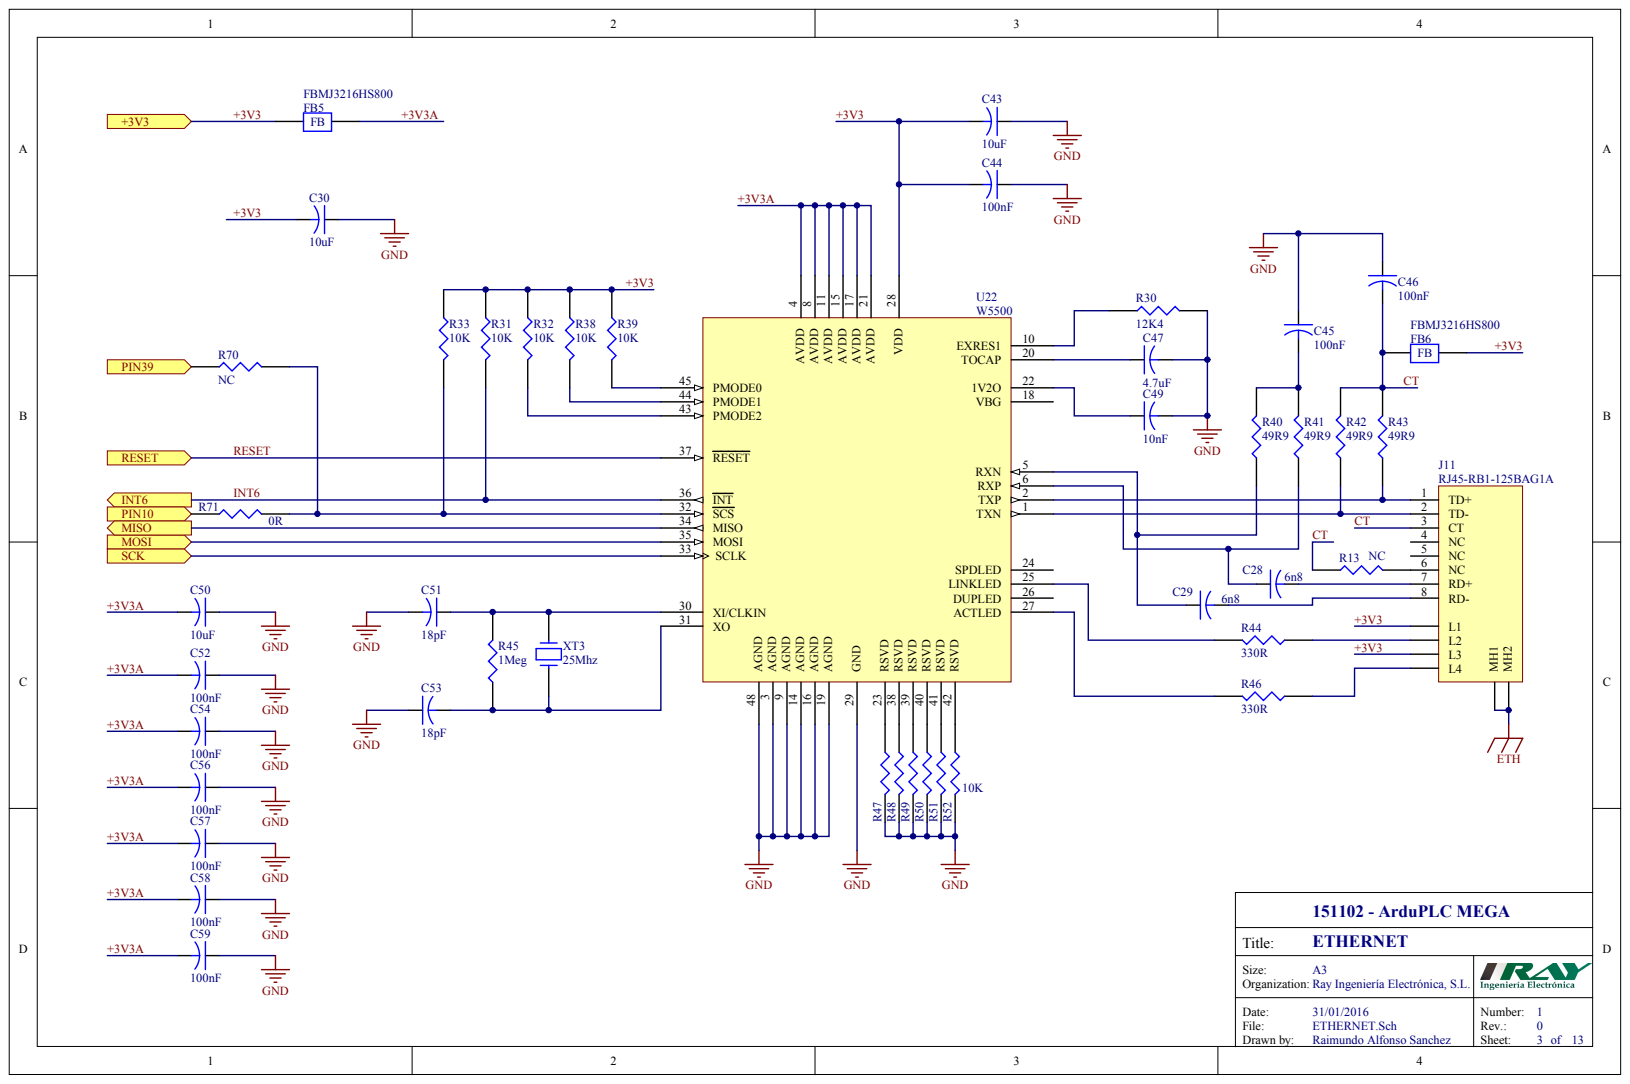
[picture p113: page 3]

Size: A3 Organization: Ray Ingeniería Electrónica, S.L.

Date: 31/01/2016 File: ETHERNET.Sch Drawn by: Raimundo Alfonso Sanchez | Number: 1 0 Sheet: 3 13

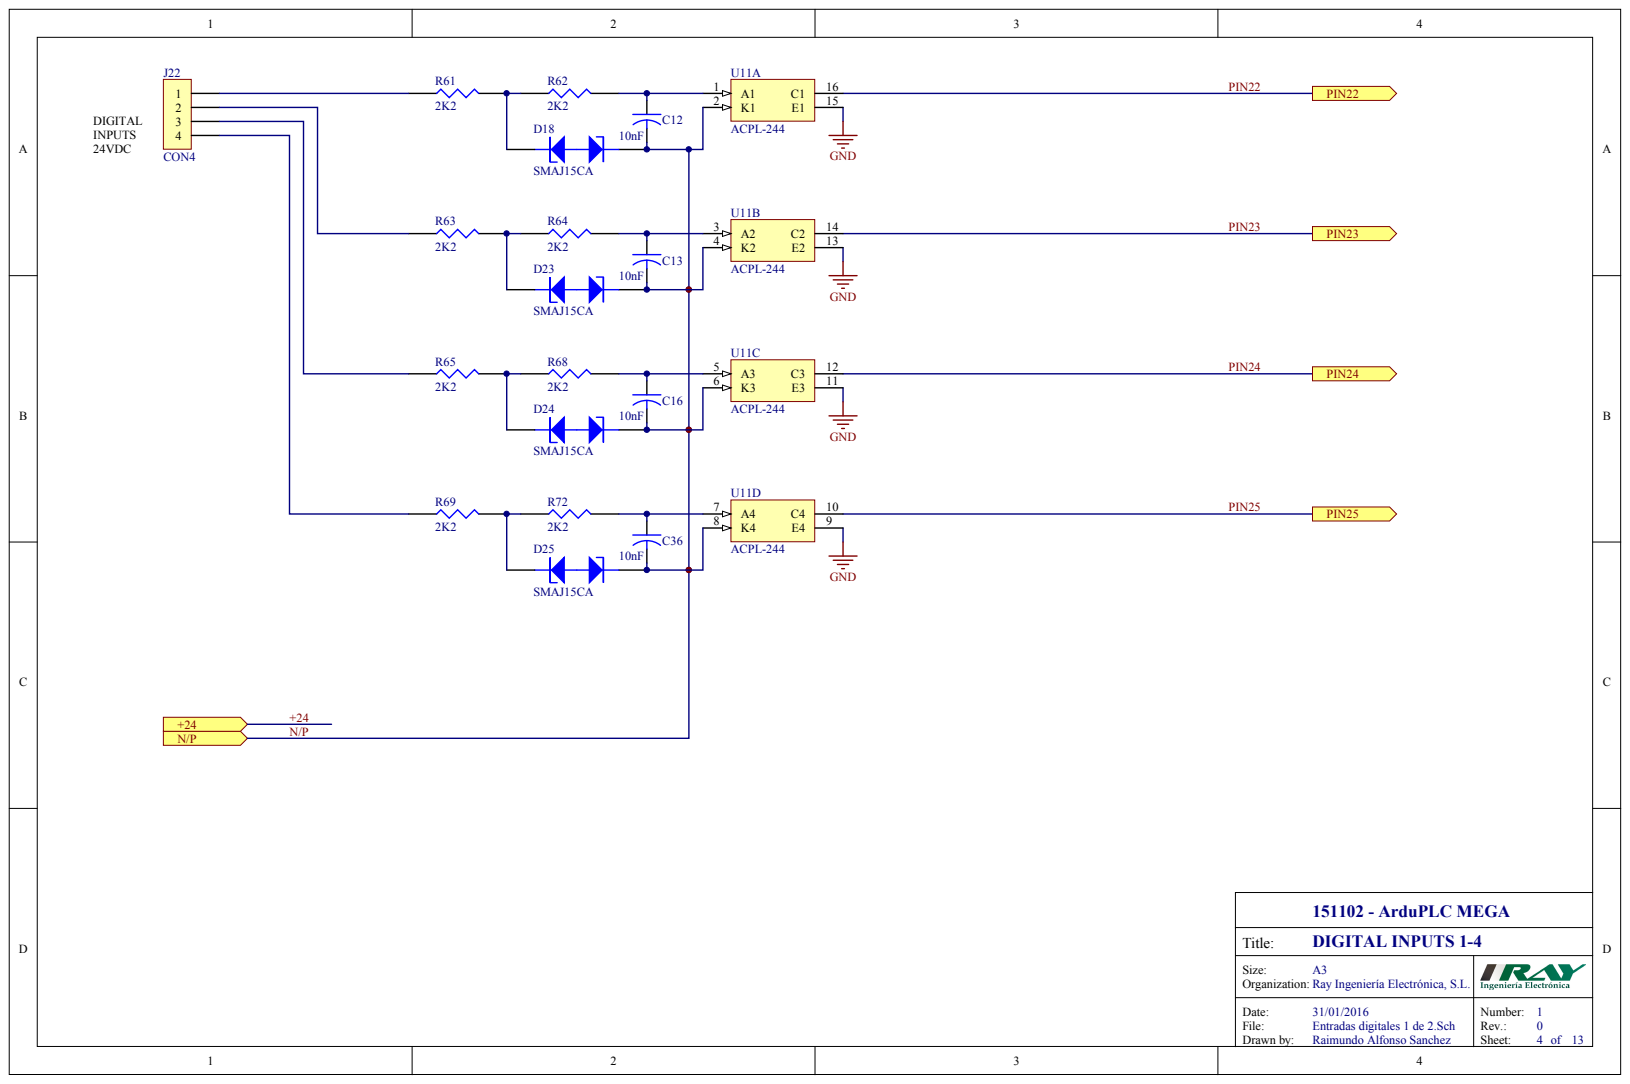
[picture p114: page 4]

Size : A 3 Organiza tion: Ray In g enierí a Electrónica, S.L.

Date: File: 31/01/2016 Entradas digita es 1 de 2. Sch | Number: 04 13 1

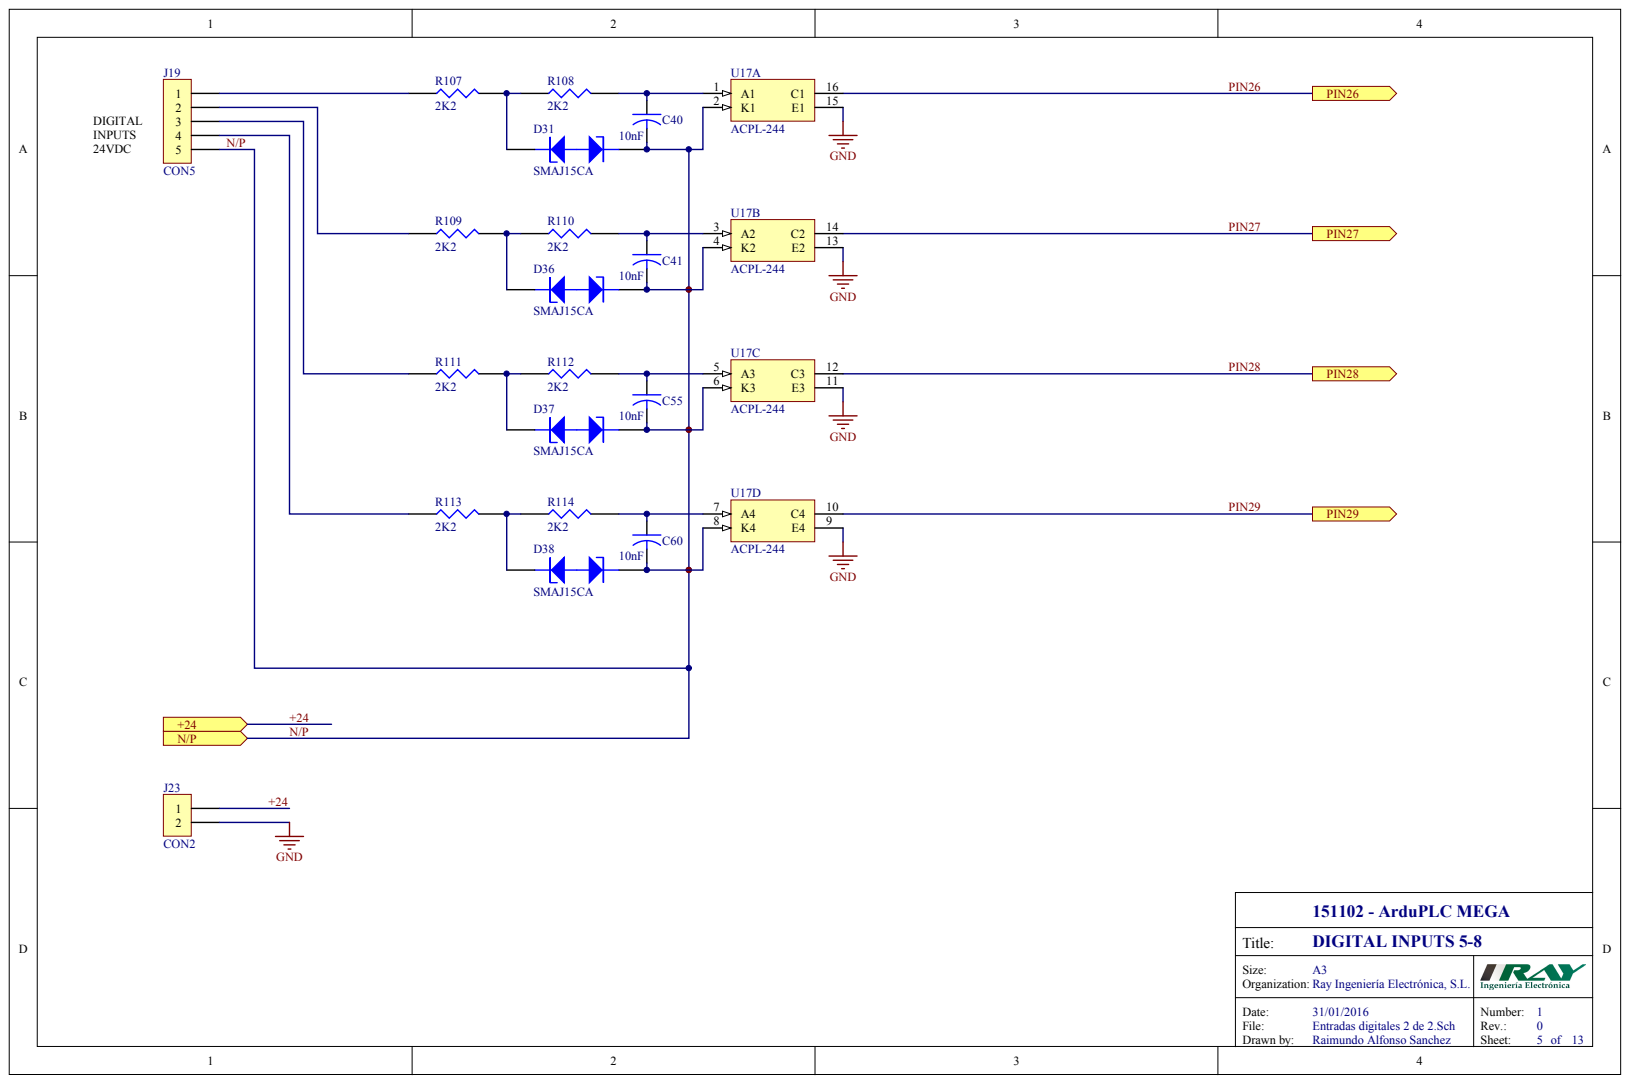
[picture p115: page 5]

Size : A 3 Organiza tion: Ray In g enierí a Electrónica, S.L.

Date: File: 31/01/2016 Entradas digita es 2 de 2. Sch | Number: 05 13 1

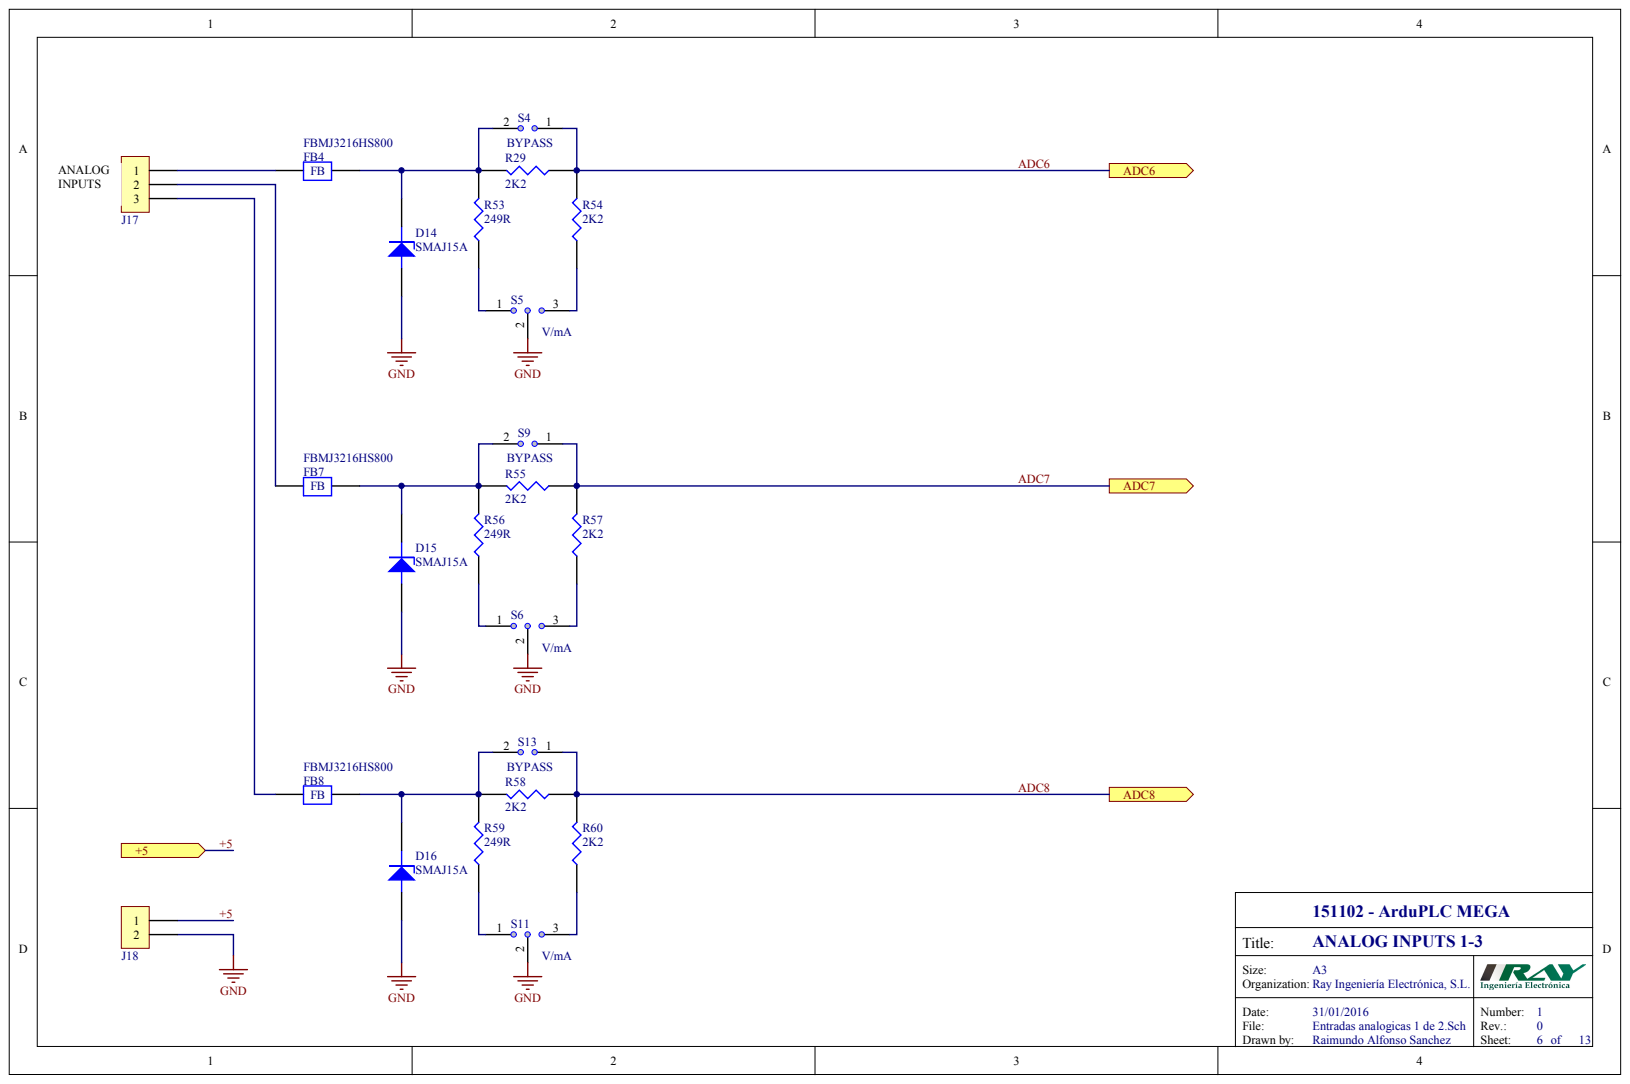
[picture p116: page 6]

Size : A 3 Organiza tion: g enierí a Electrónica, S.L.

Date: File: 31/01/2016 Entradas analo gicas 1 de 2.Sch | Number: 06 13 1

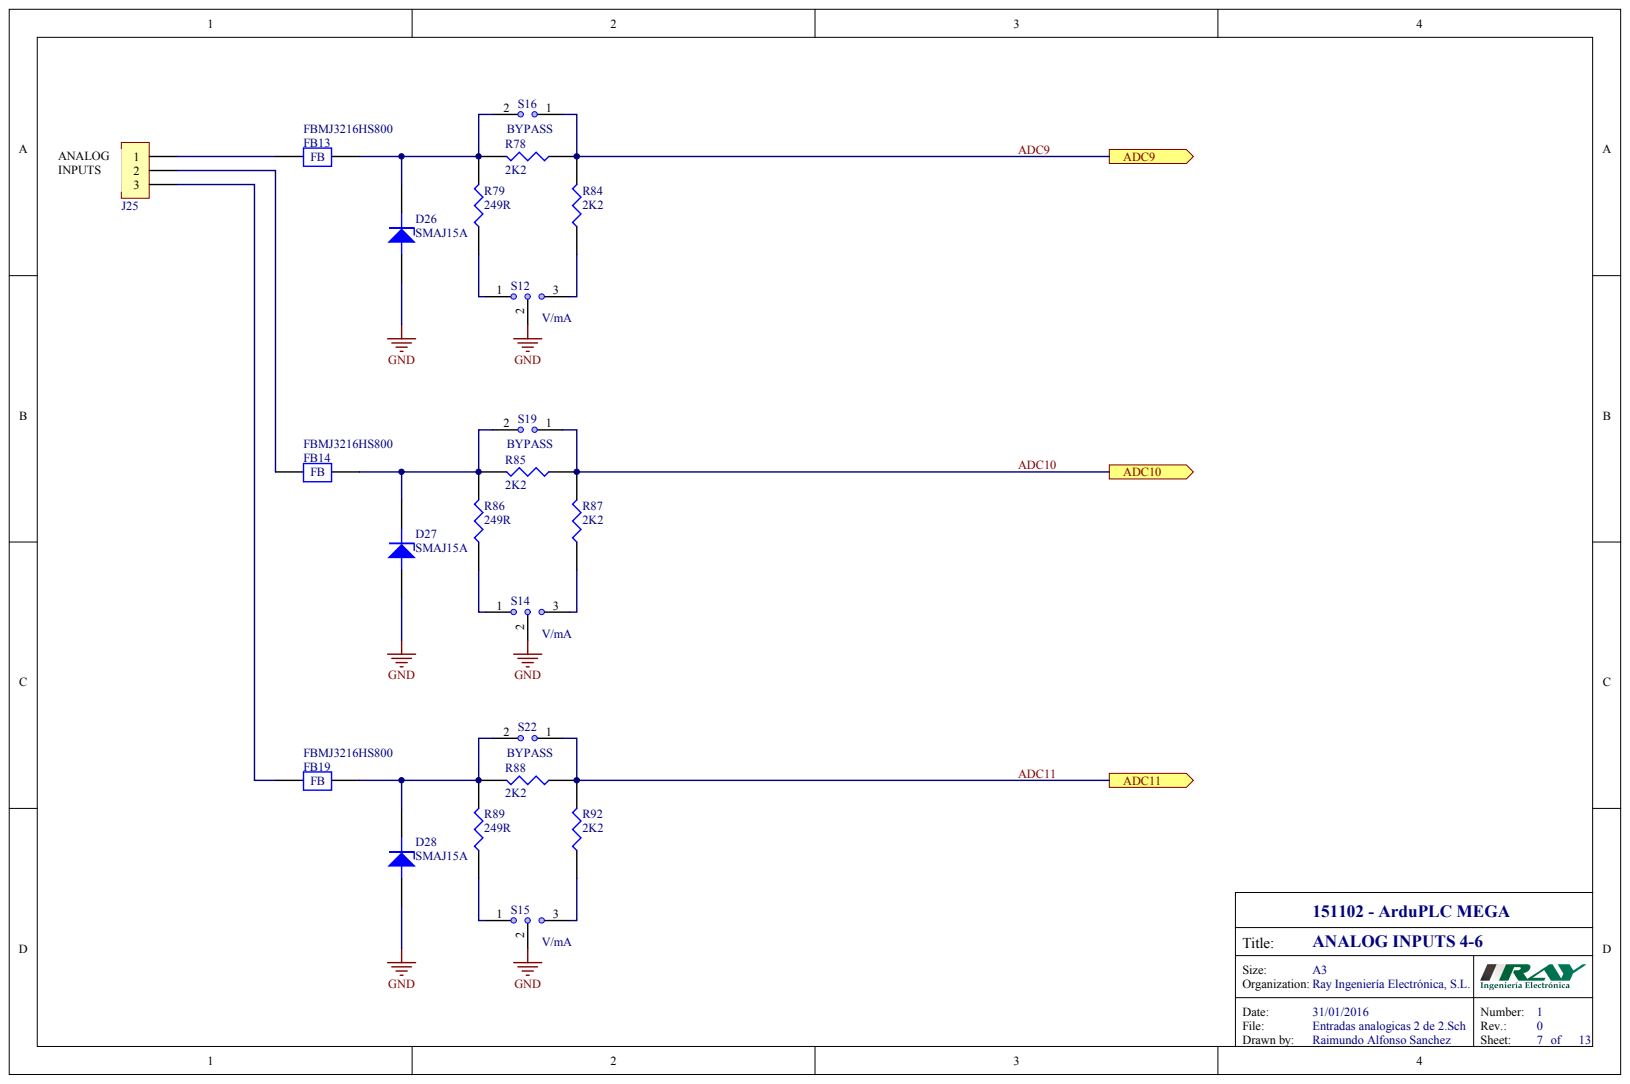
[picture p117: page 7]

Size : A 3 Organiza tion: Ray In g enierí a Electrónica, S.L.

Date: File: 31/01/2016 Entradas analo gicas 2 de 2.Sch | Number: 07 13 1

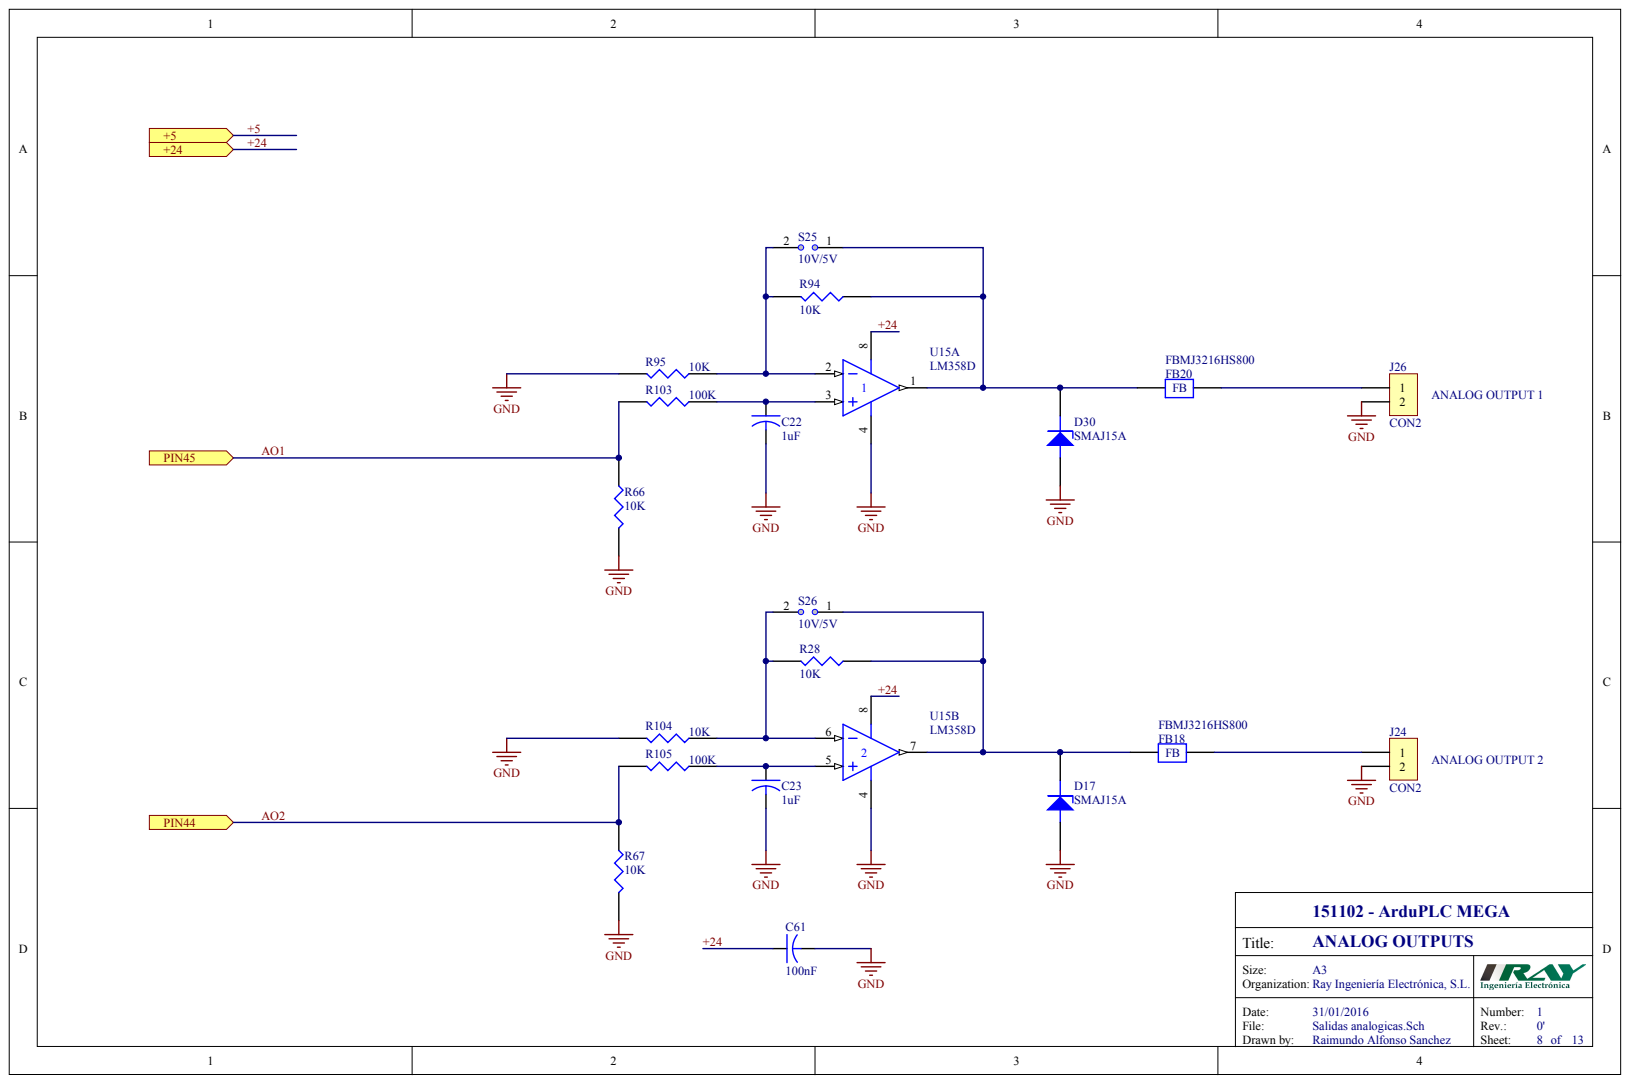
[picture p118: page 8]

Size : A 3 Organiza tion: Ray In g enierí a Electrónica, S.L.

Date: File: 31/01/2016 Salidas ana gicas.Sch o | Number: 0' 8 13 1

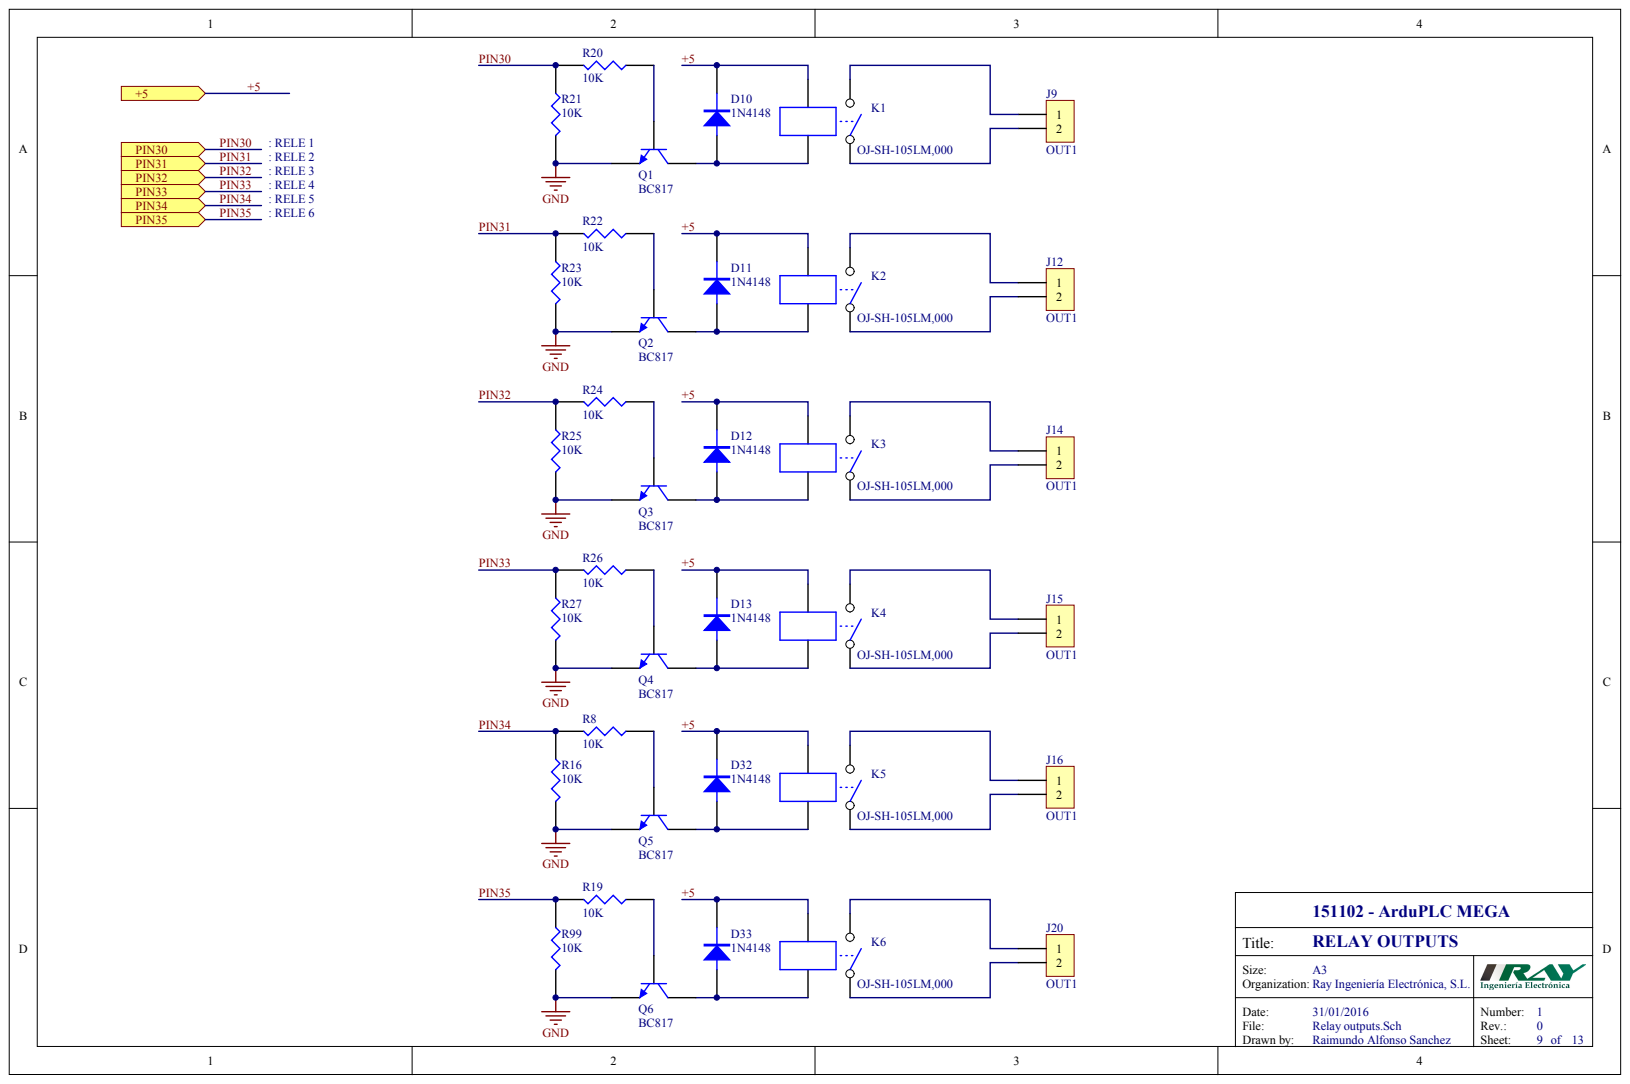
[picture p119: page 9]

Size : A 3 Organiza tion: Ray In g enierí a Electrónica, S.L.

Date: File: 31/01/2016 Rela y outputs. S c h | Number: 09 13 1

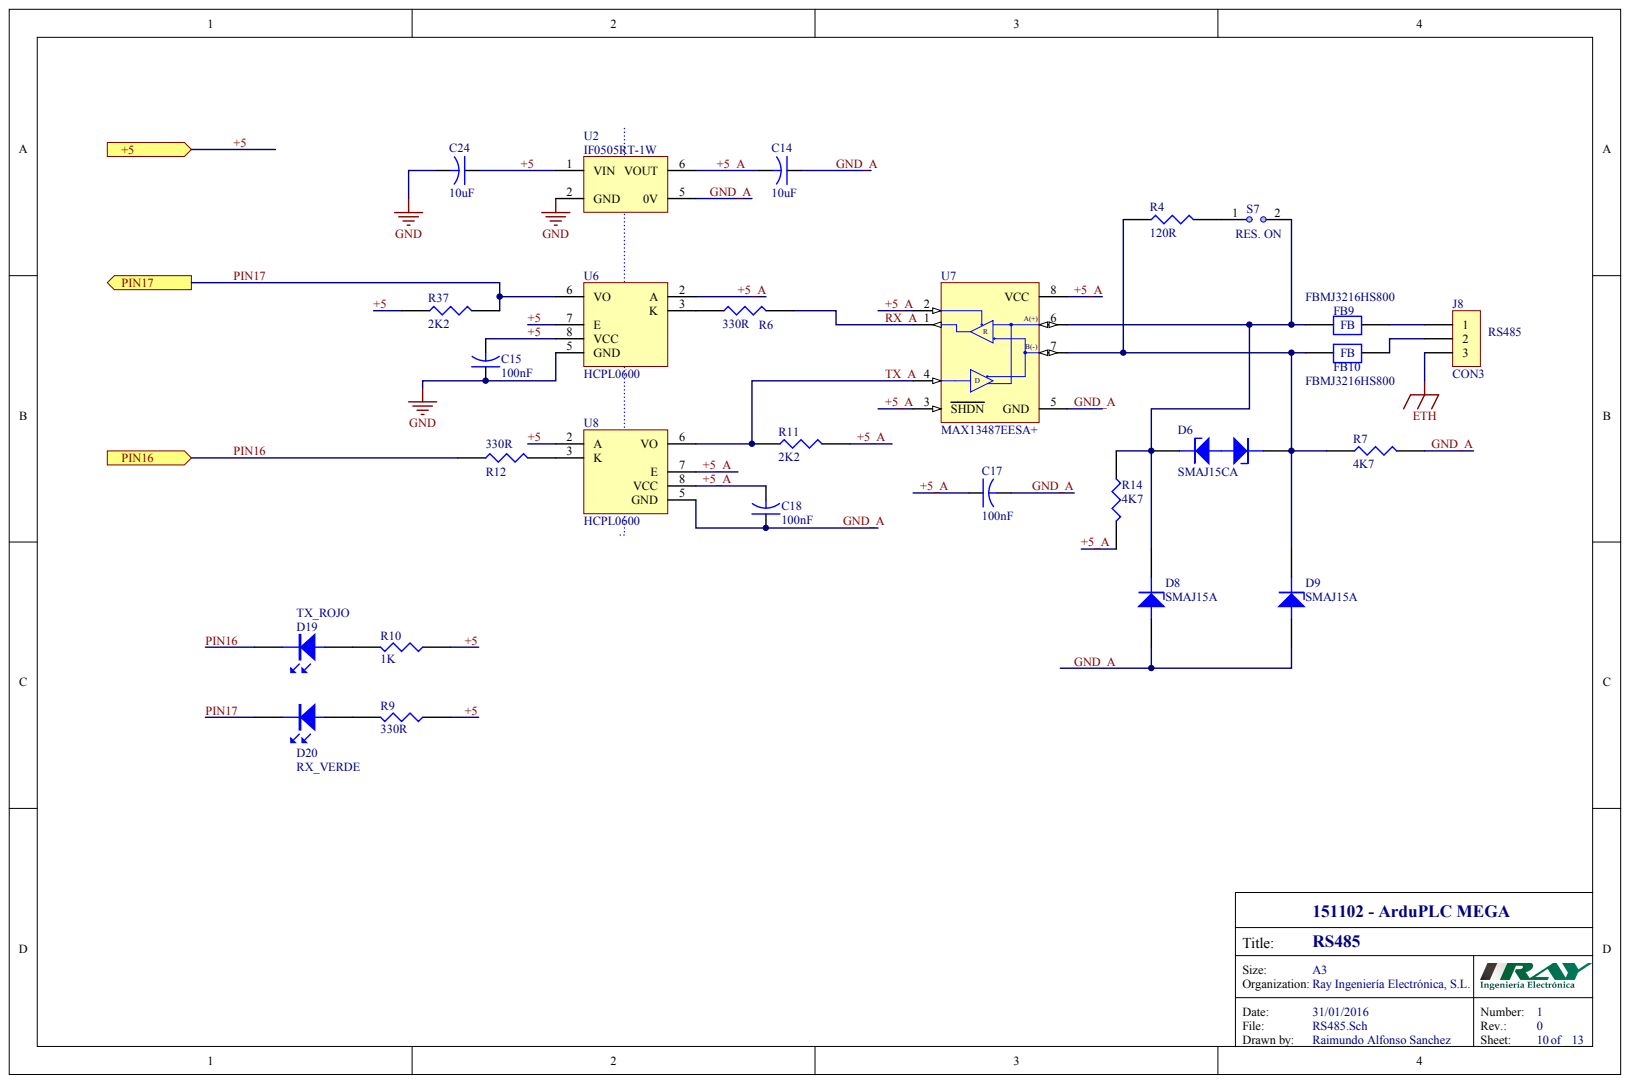
[picture p120: page 10]

GND 5

Size: A3 Organization: Ray Ingeniería Electrónica, S.L.

Date: 31/01/2016 File: RS485.Sch Drawn by: Raimundo Alfonso Sanchez | Number: 1 0 Sheet: 10 13

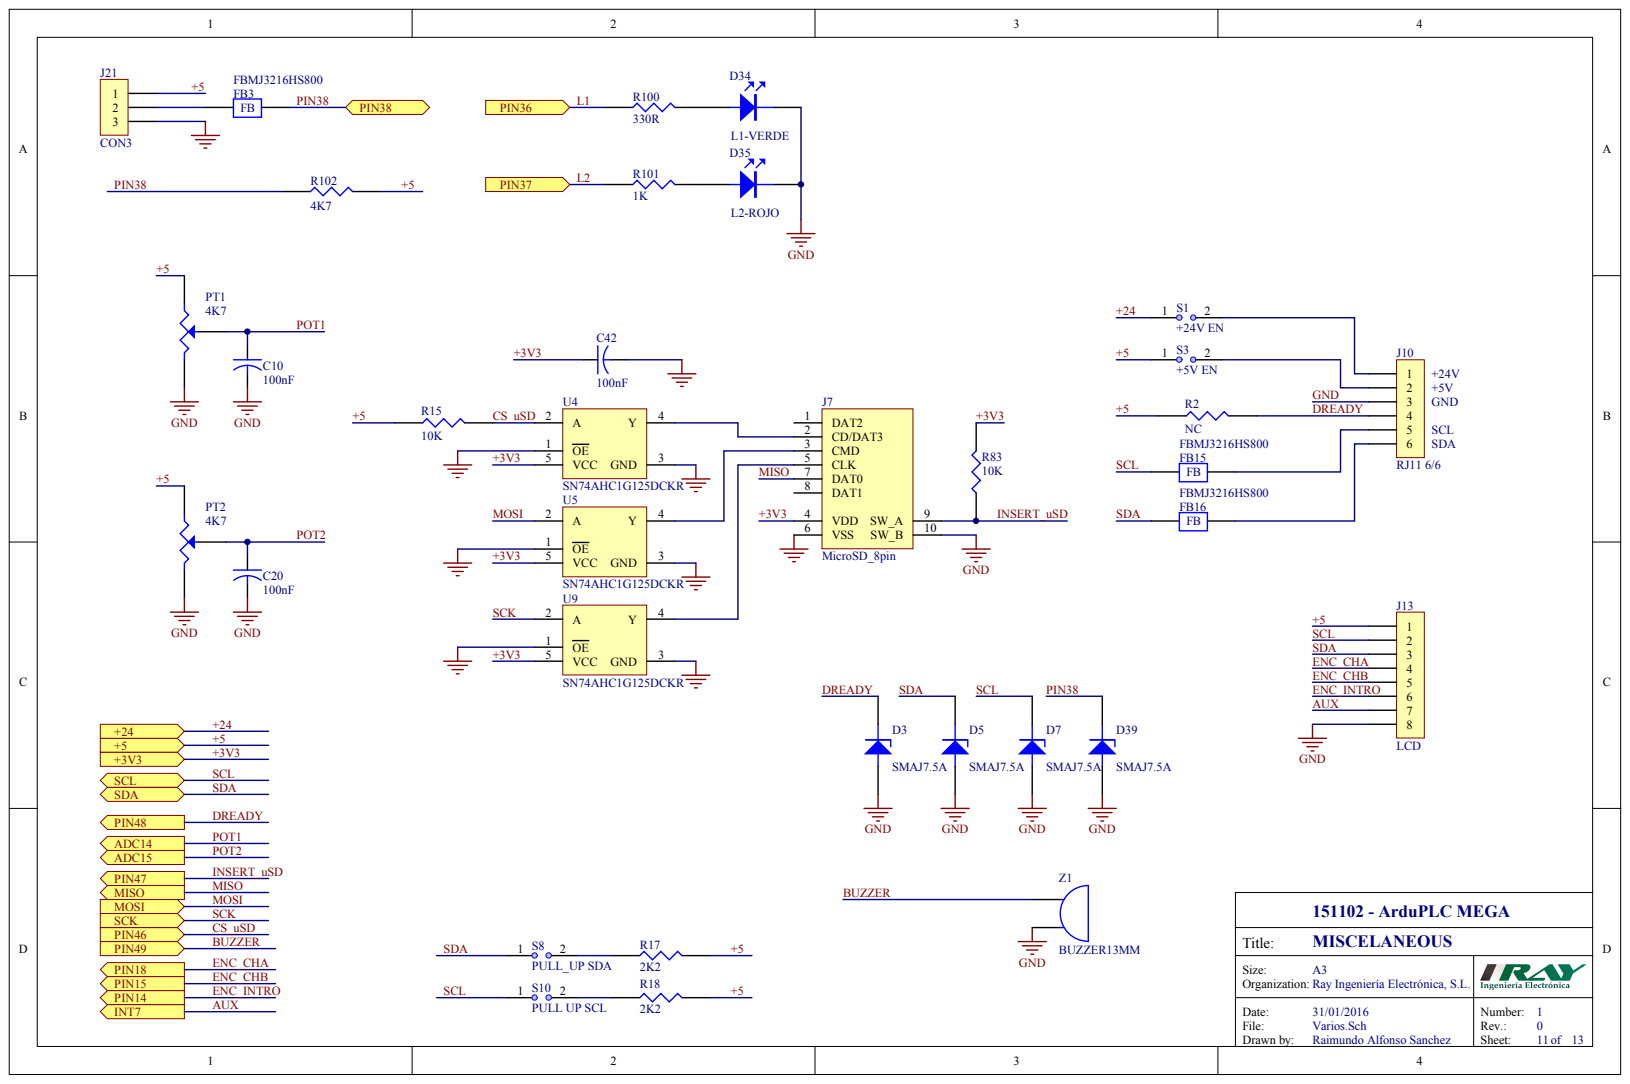
[picture p121: page 11]

Size: A3 Organization: Ray Ingeniería Electrónica, S.L.

Date: 31/01/2016 File: Varios.Sch Drawn by: Raimundo Alfonso Sanchez | Number: 1 0 Sheet: 11 13

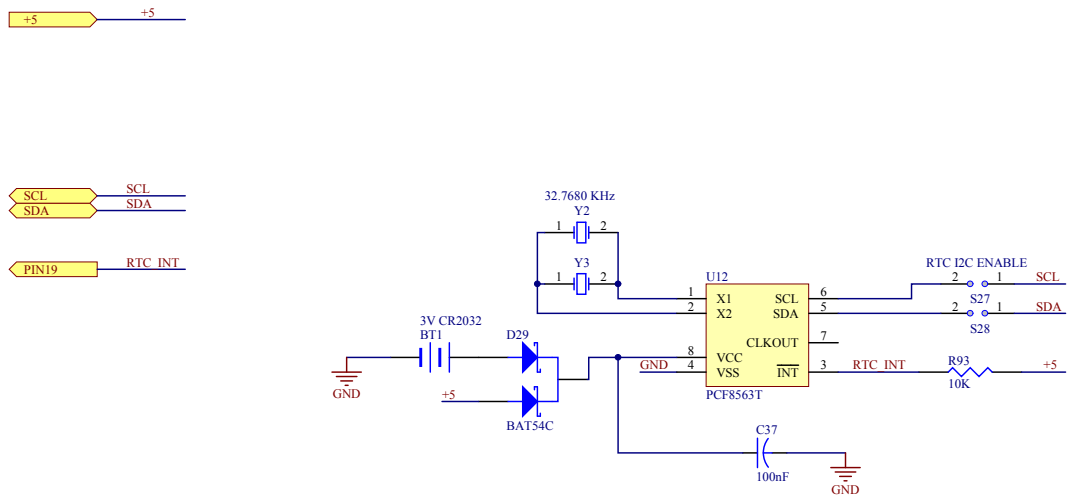
[picture p122: page 12]

Size: A3 Organization: Ray Ingeniería Electrónica, S.L.

Date: 31/01/2016 File: RTC.Sch Drawn by: Raimundo Alfonso Sanchez | Number: 1 Sheet: 12 13

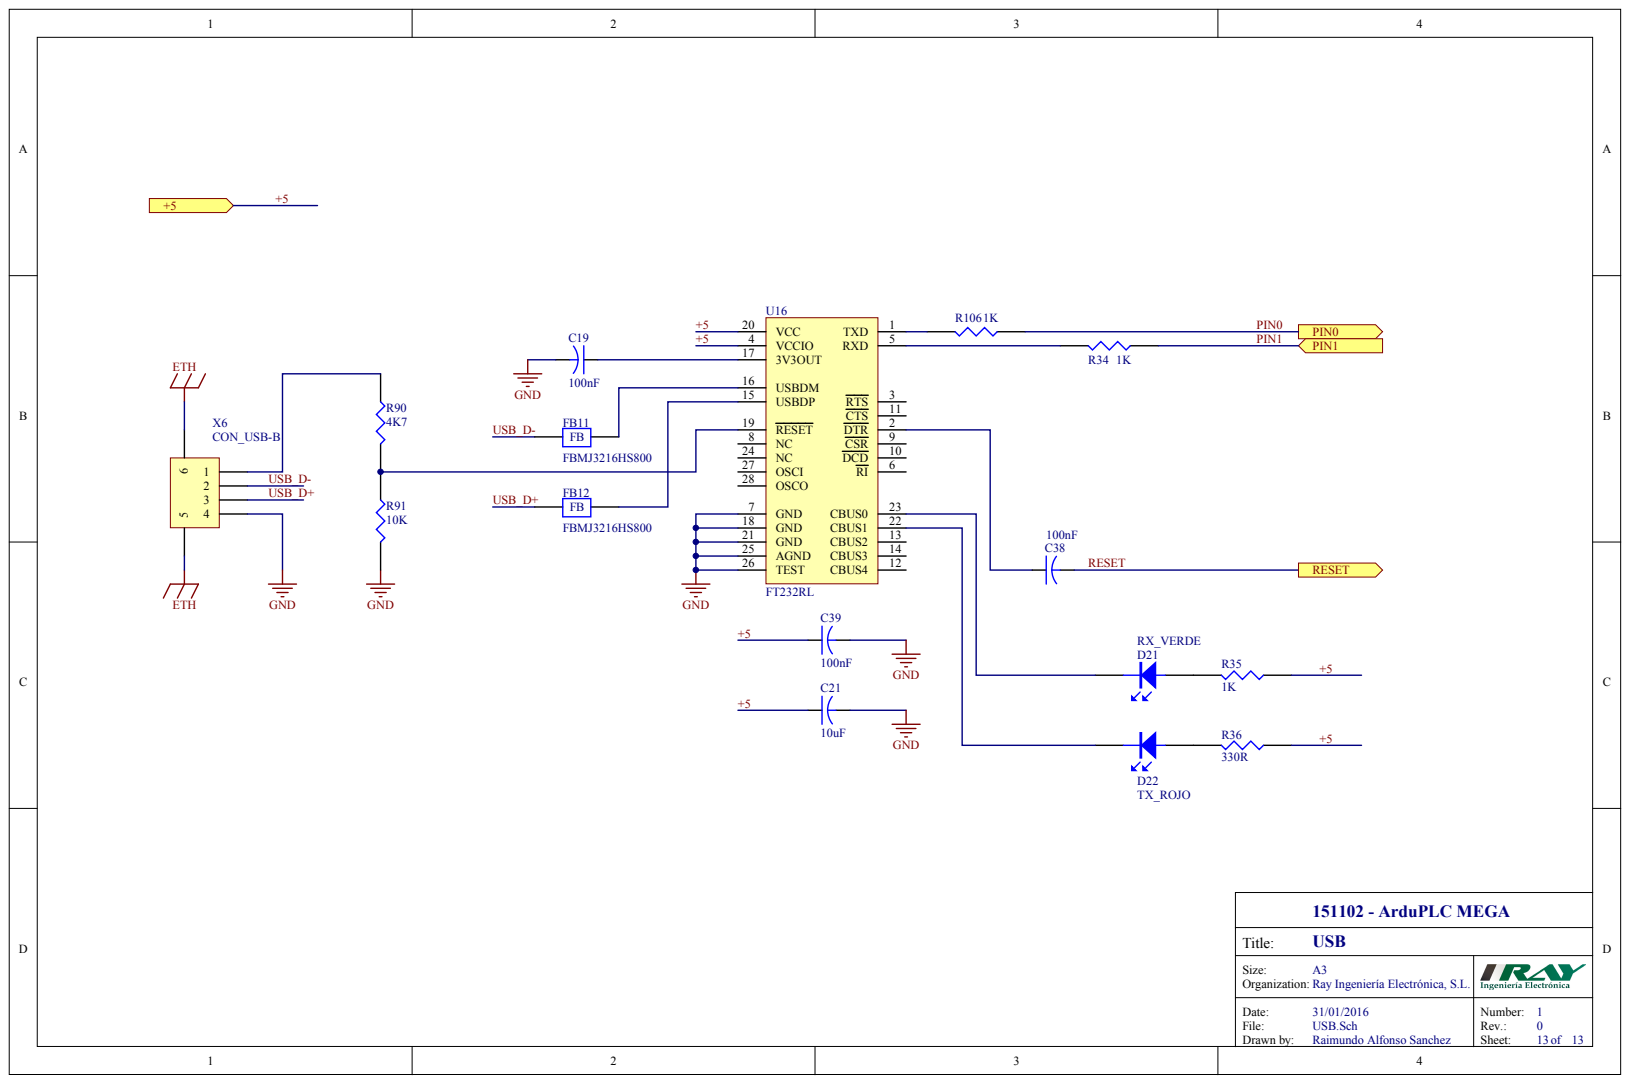
[picture p123: page 13]

Size: A3 Organization: Ray Ingeniería Electrónica, S.L.

Date: 31/01/2016 File: USB.Sch Drawn by: Raimundo Alfonso Sanchez | Number: 1 0 Sheet: 13 13
