raymirabel/ArduPLC/ArduPLC NANO/doc/ArduPLC_Nano_Schematic.pdf

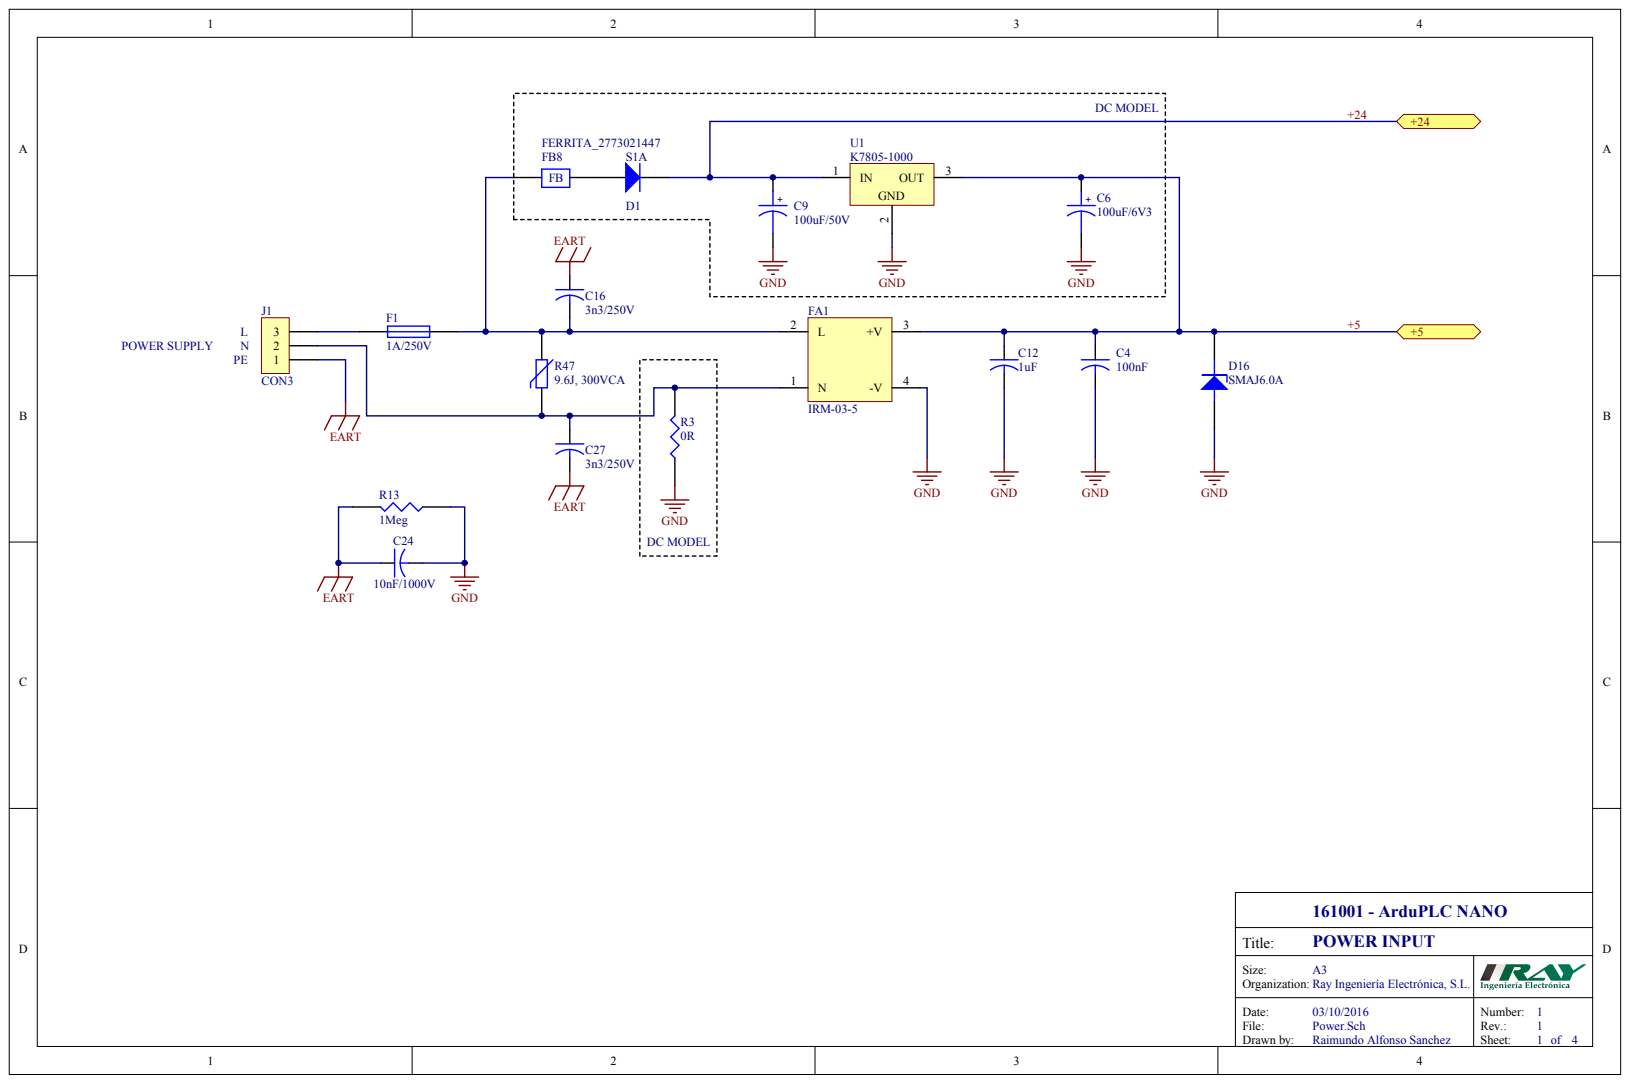
[picture p124: page 1]

Size : A 3 Organiza tion: Ray In g enierí a Electrónica, S.L.

Date: File: 03/10/2016 Power.Sch Drawn by : Raimundo A l fonso Sanche z | Number: 1 Rev.: Sheet: of

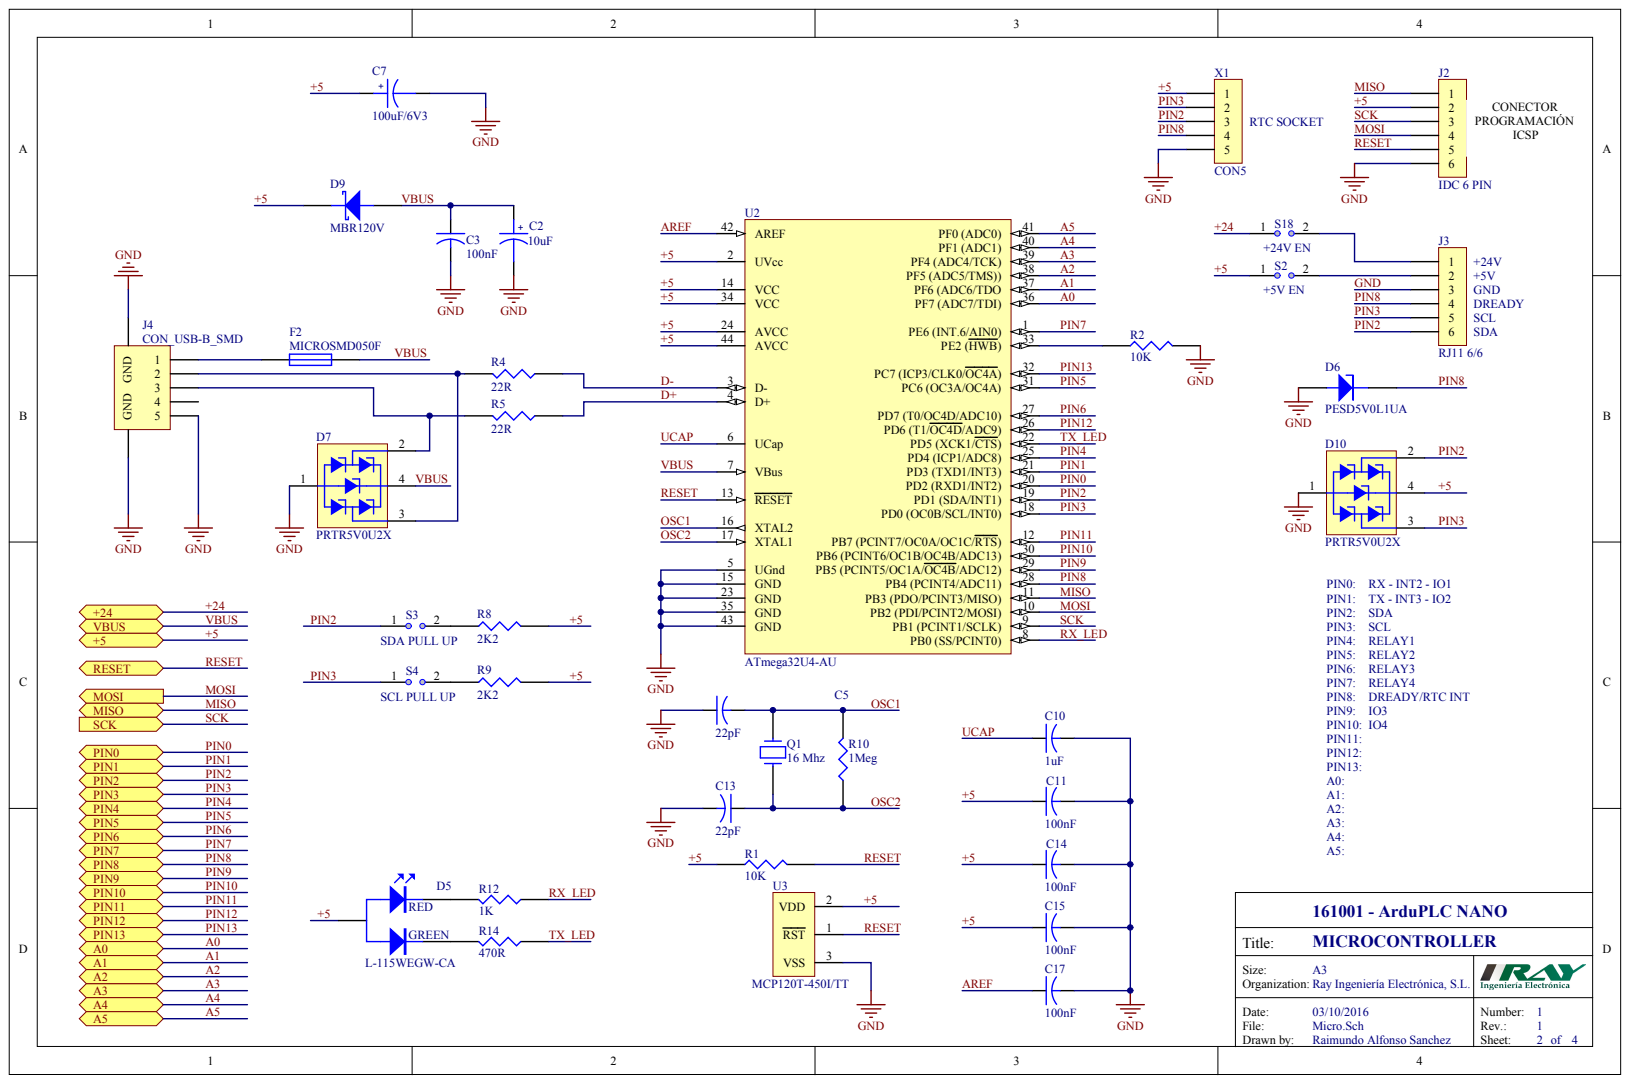
[picture p125: page 2]

Size: A3 Organization: Ray Ingeniería Electrónica, S.L.

Date: 03/10/2016 File: Micro.Sch Drawn by: Raimundo Alfonso Sanchez | Number: 1 1 Sheet: 2 4

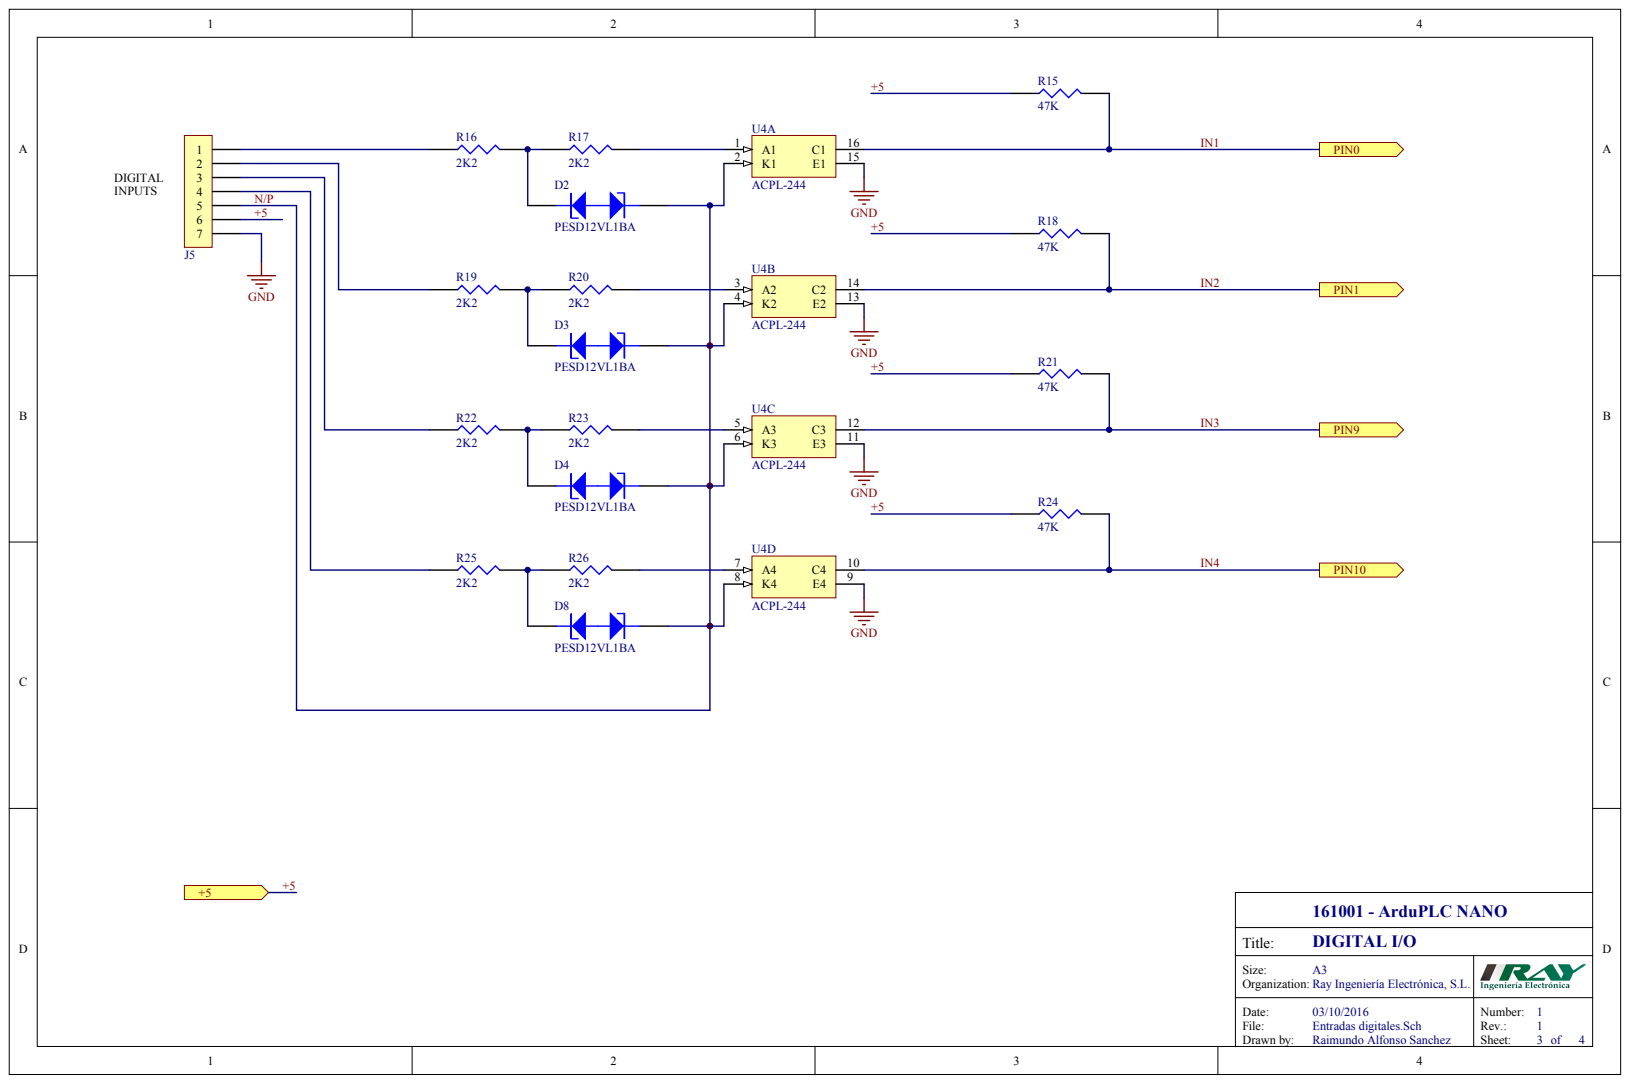
[picture p126: page 3]

Size: A3 Organization: Ray Ingeniería Electrónica, S.L.

Date: 03/10/2016 File: Entradas digitales.Sch Drawn by: Raimundo Alfonso Sanchez | Number: 1 1 Sheet: 3 4

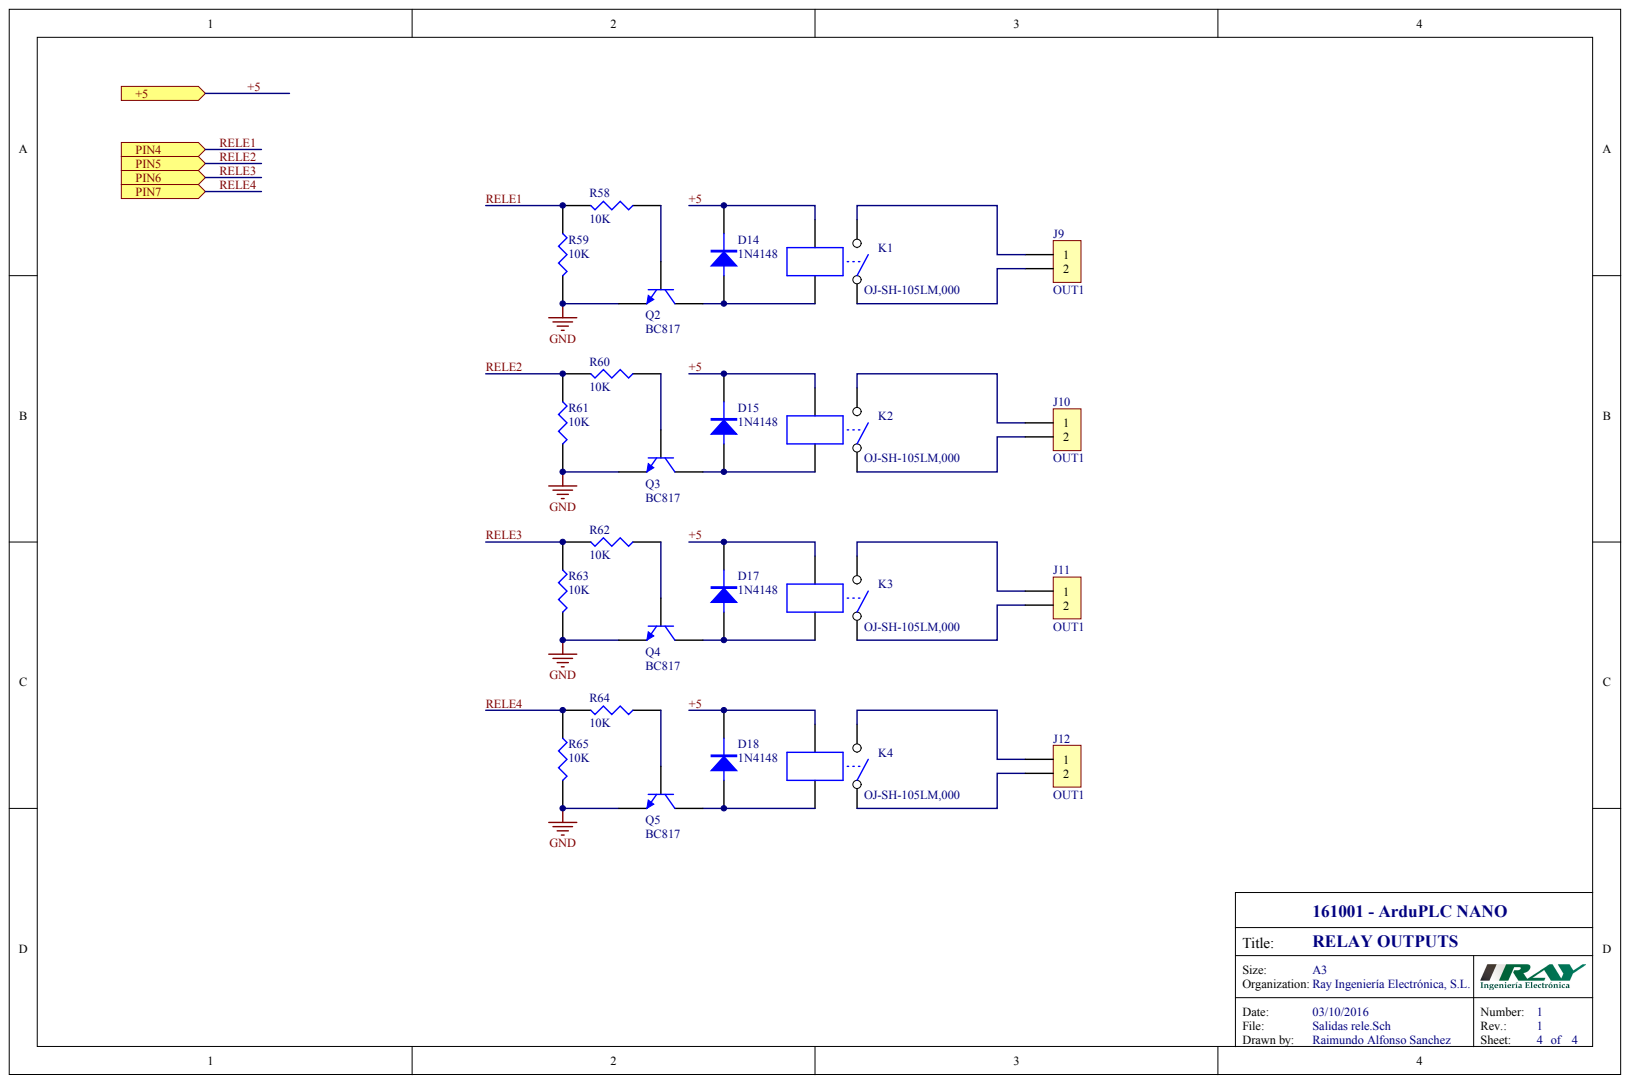
[picture p127: page 4]

Size : A 3 Organiza tion: Ray In g enierí a Electrónica, S.L.

Date: File: 03/10/2016 Salidas rele.S c h Drawn by : Raimundo A l fonso Sanche z | Number: 1 Sheet:
