raymirabel/ArduPLC/ArduPLCm/Esquemas ArduPLCm-120421.pdf

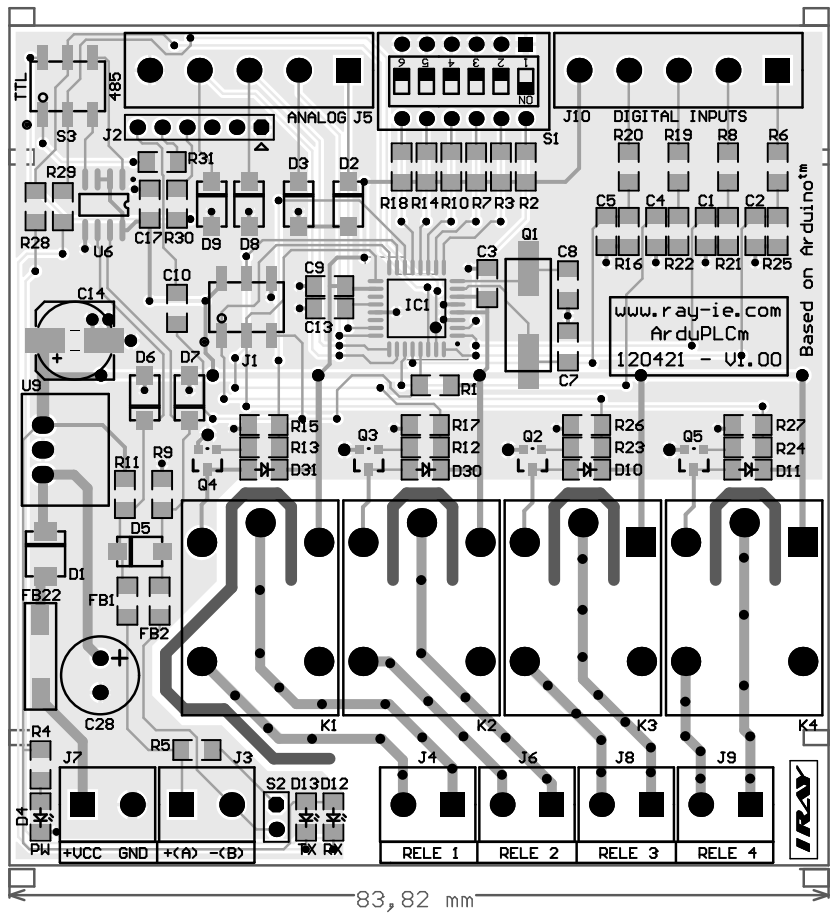
[picture p128: page 1]

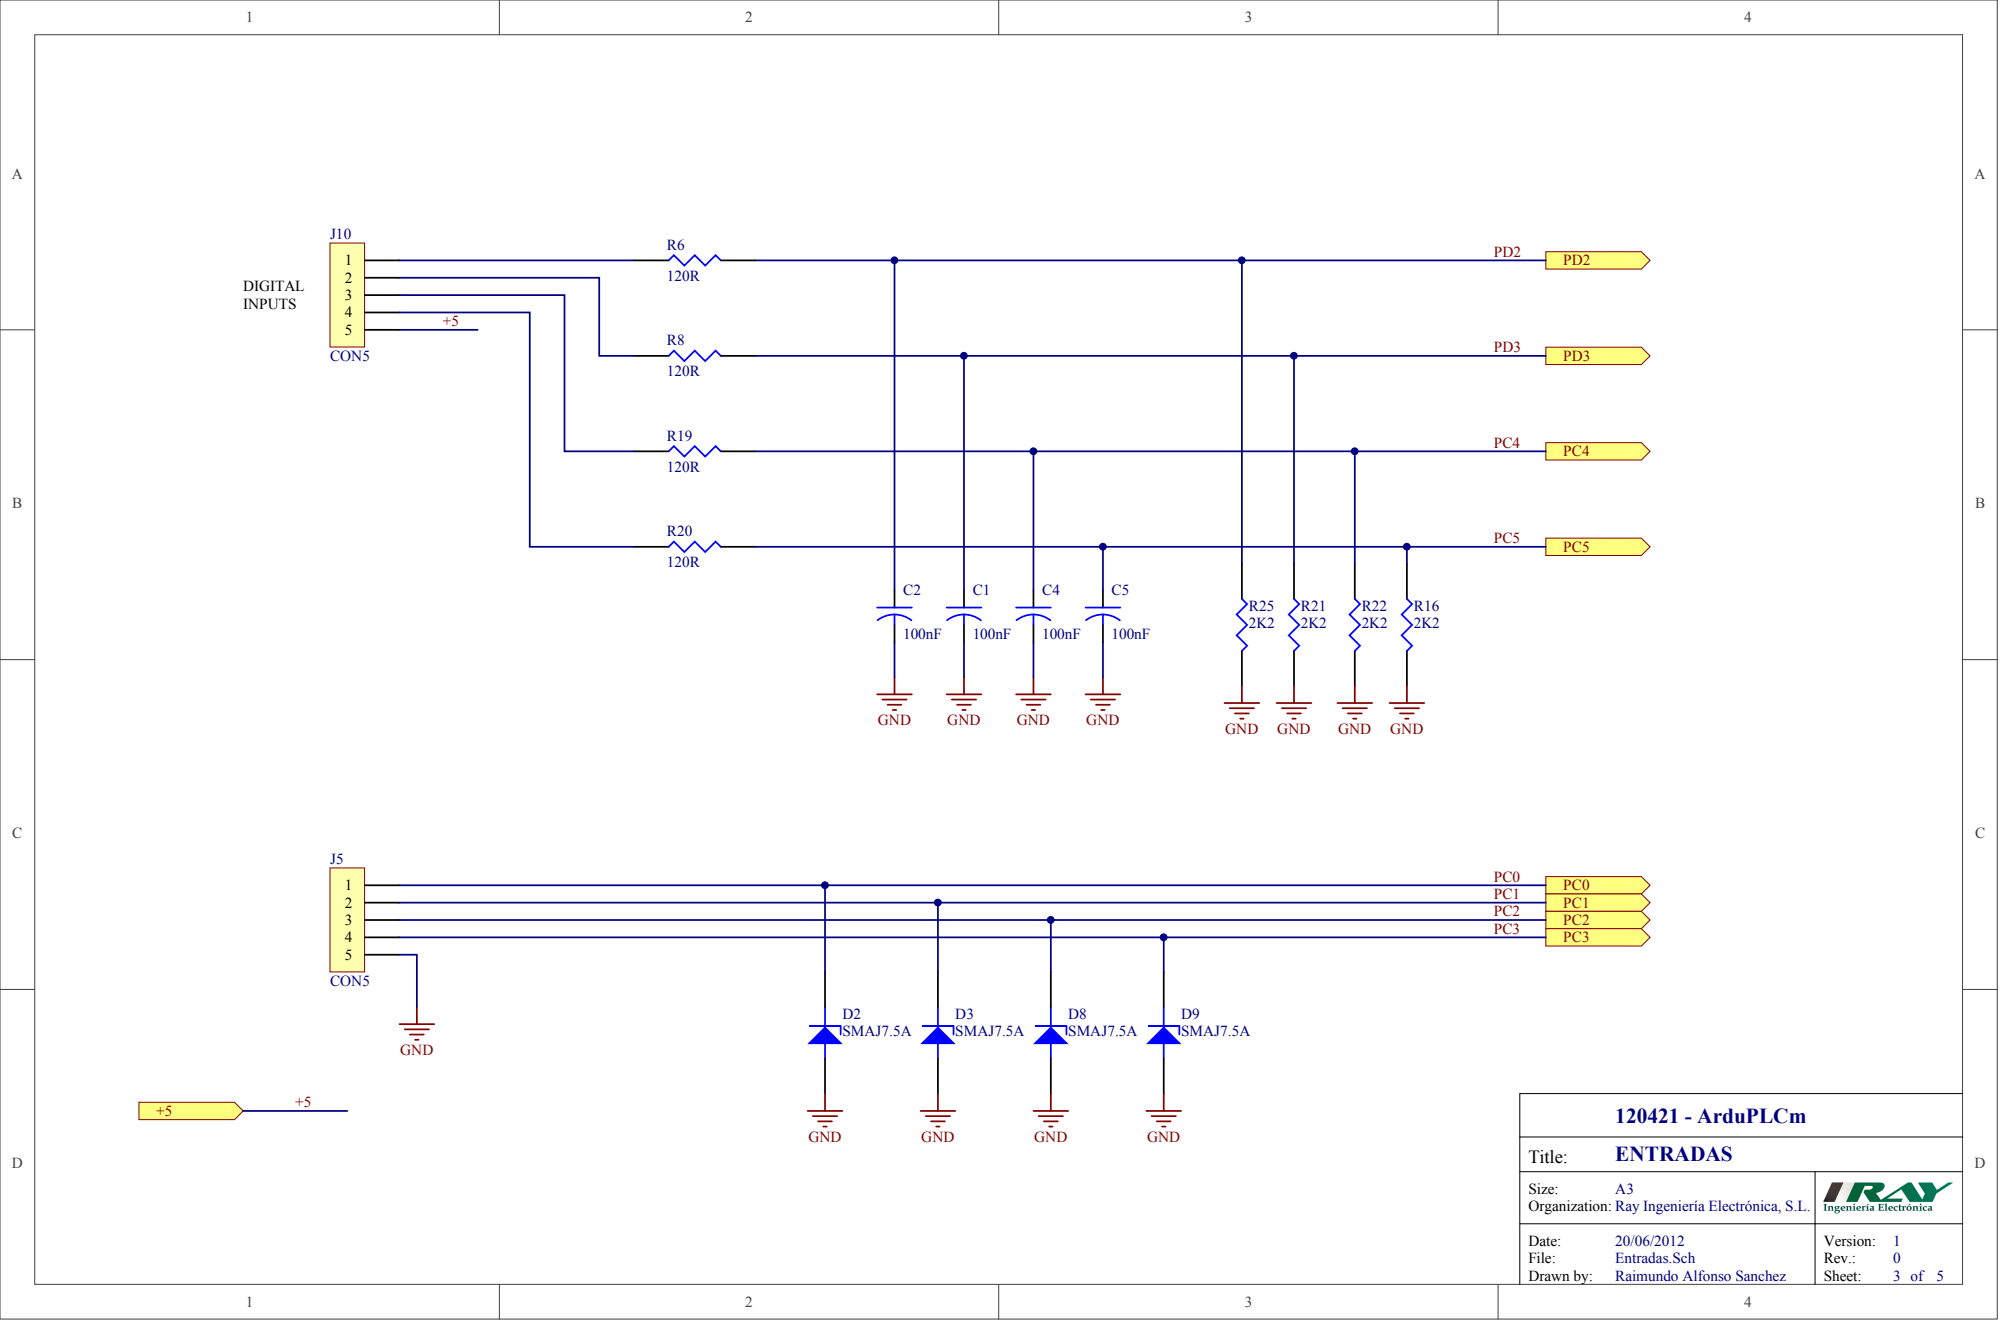
[picture p129: page 2]

Size: A3 Organization: Ray Ingeniería Electrónica, S.L .

Date: File: 20/06/2012 Entradas.Sch Drawn by : Raimundo Alfonso Sanchez | Version: 1 Rev.: 0 Sheet: 3 of 5

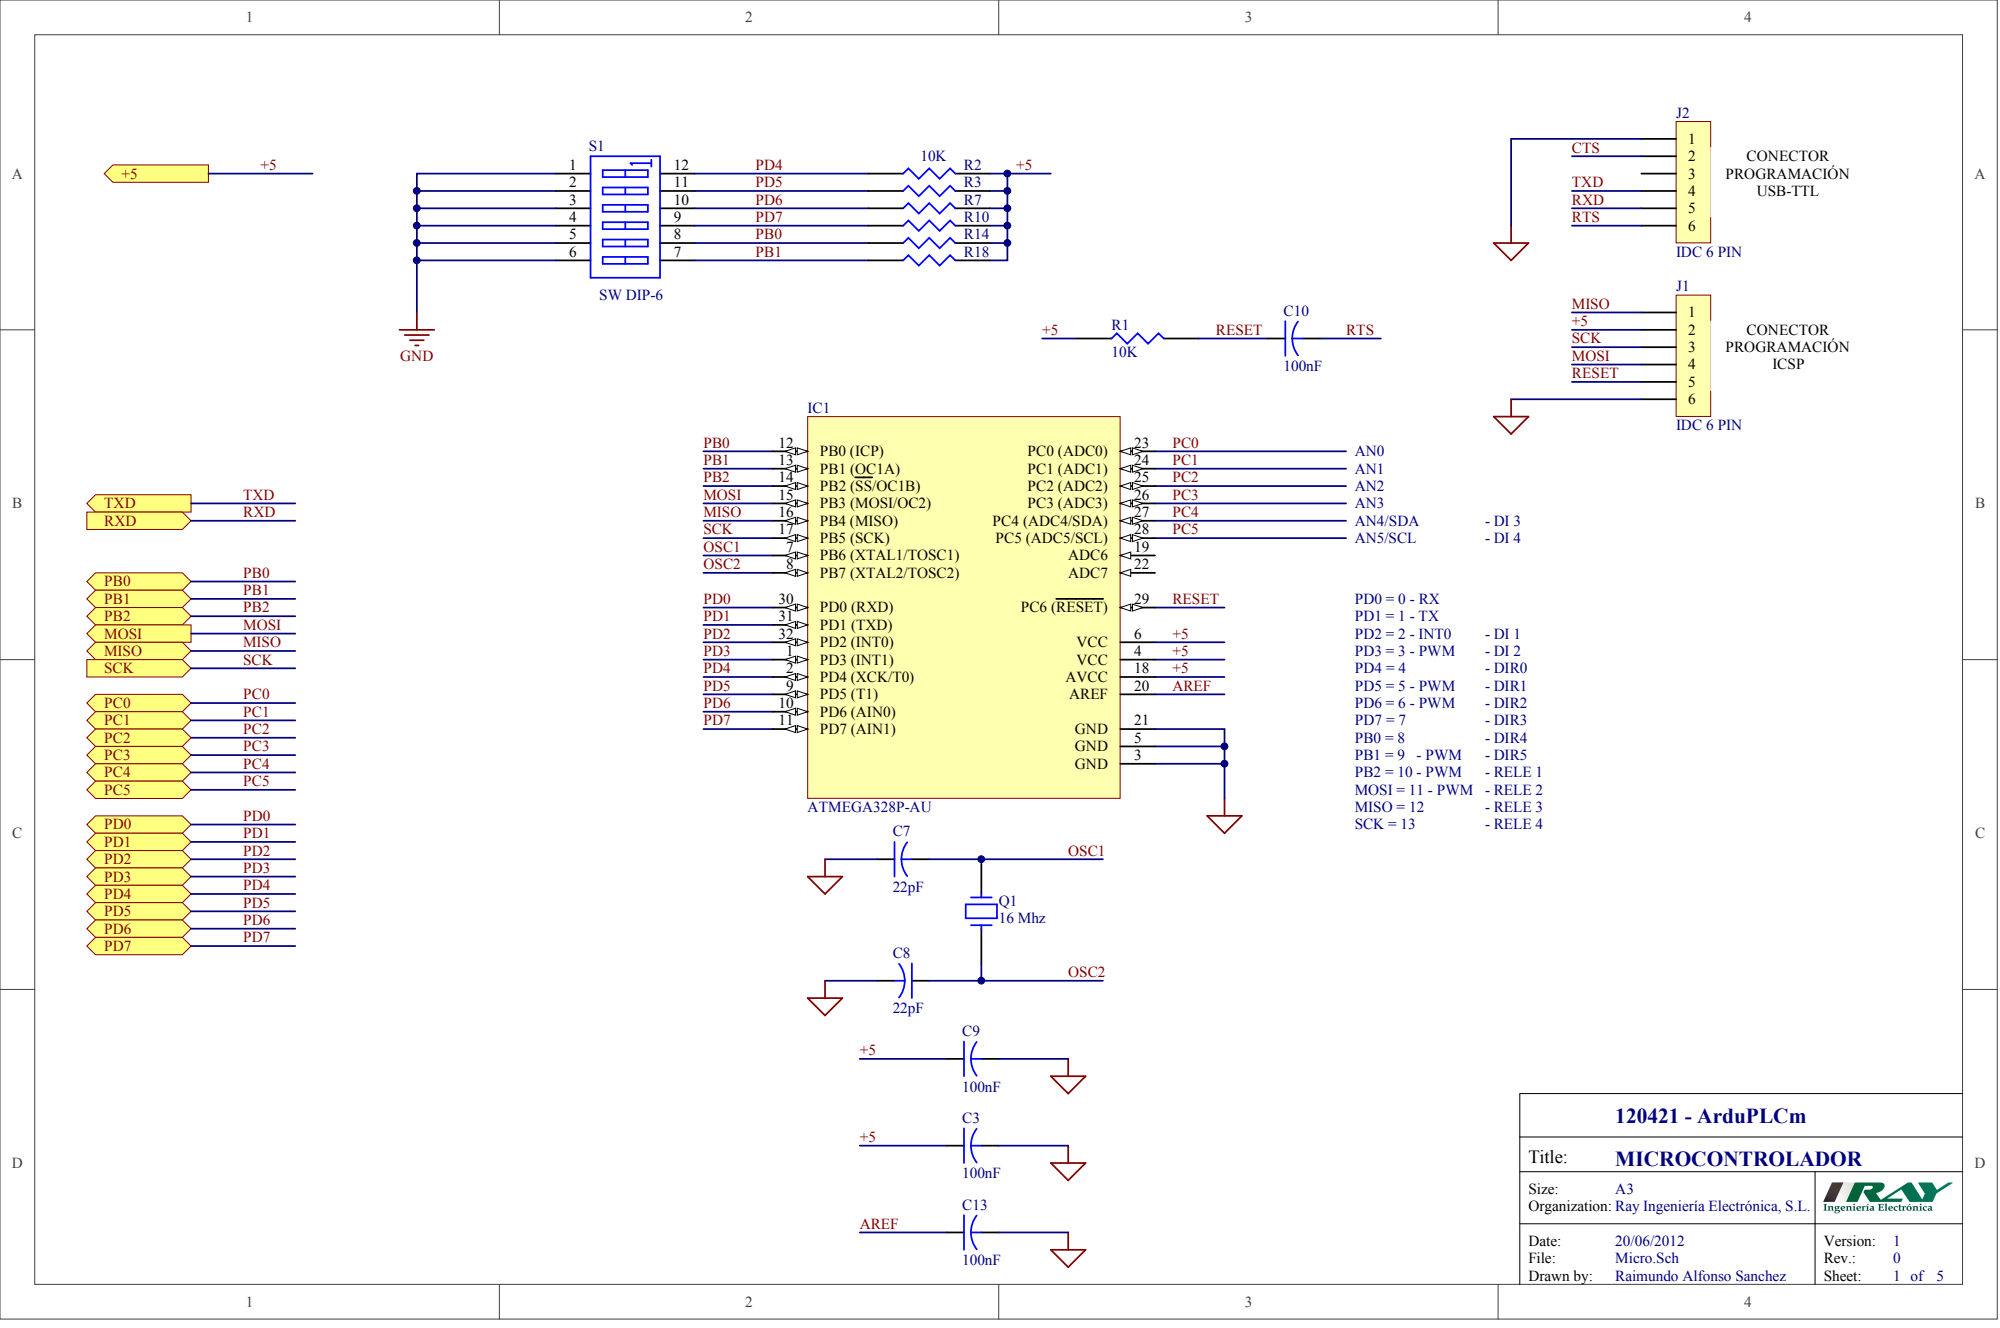
[picture p130: page 3]

3 P0S103 P0S103
4 P0S104 P0S104
5 P0S105 P0S105

Size: A3 Organization: Ray Ingeniería Electrónica, S.L.

Date: 20/06/2012 File: Micro.Sch Drawn by: Raimundo Alfonso Sanchez | Version: 1 Rev.: 0 Sheet: 1 of 5

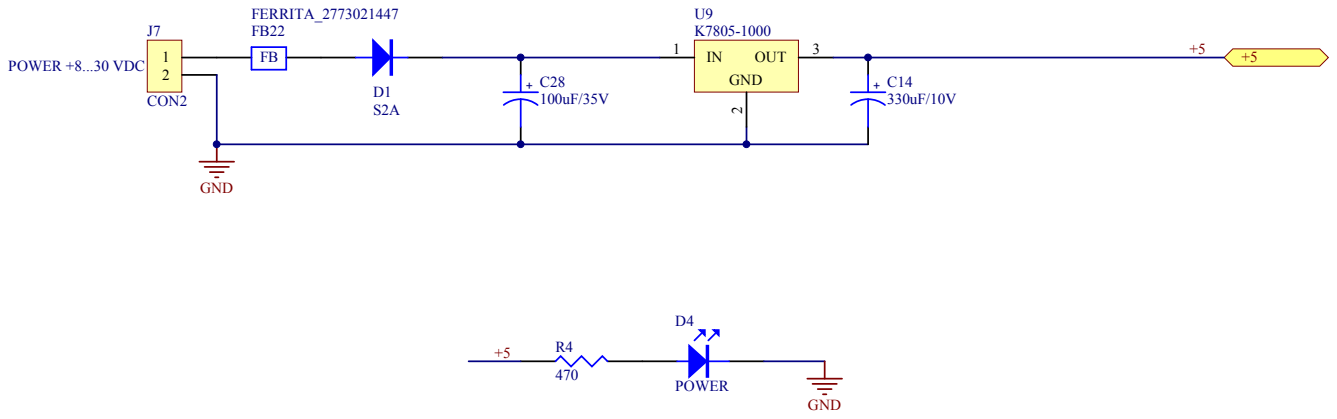
[picture p131: page 4]

Size: A3 Organization: Ray Ingeniería Electrónica, S.L.

Date: 20/06/2012 File: Power.Sch Drawn by: Raimundo Alfonso Sanchez | Version: 1 Rev.: 0 Sheet: 2 of 5

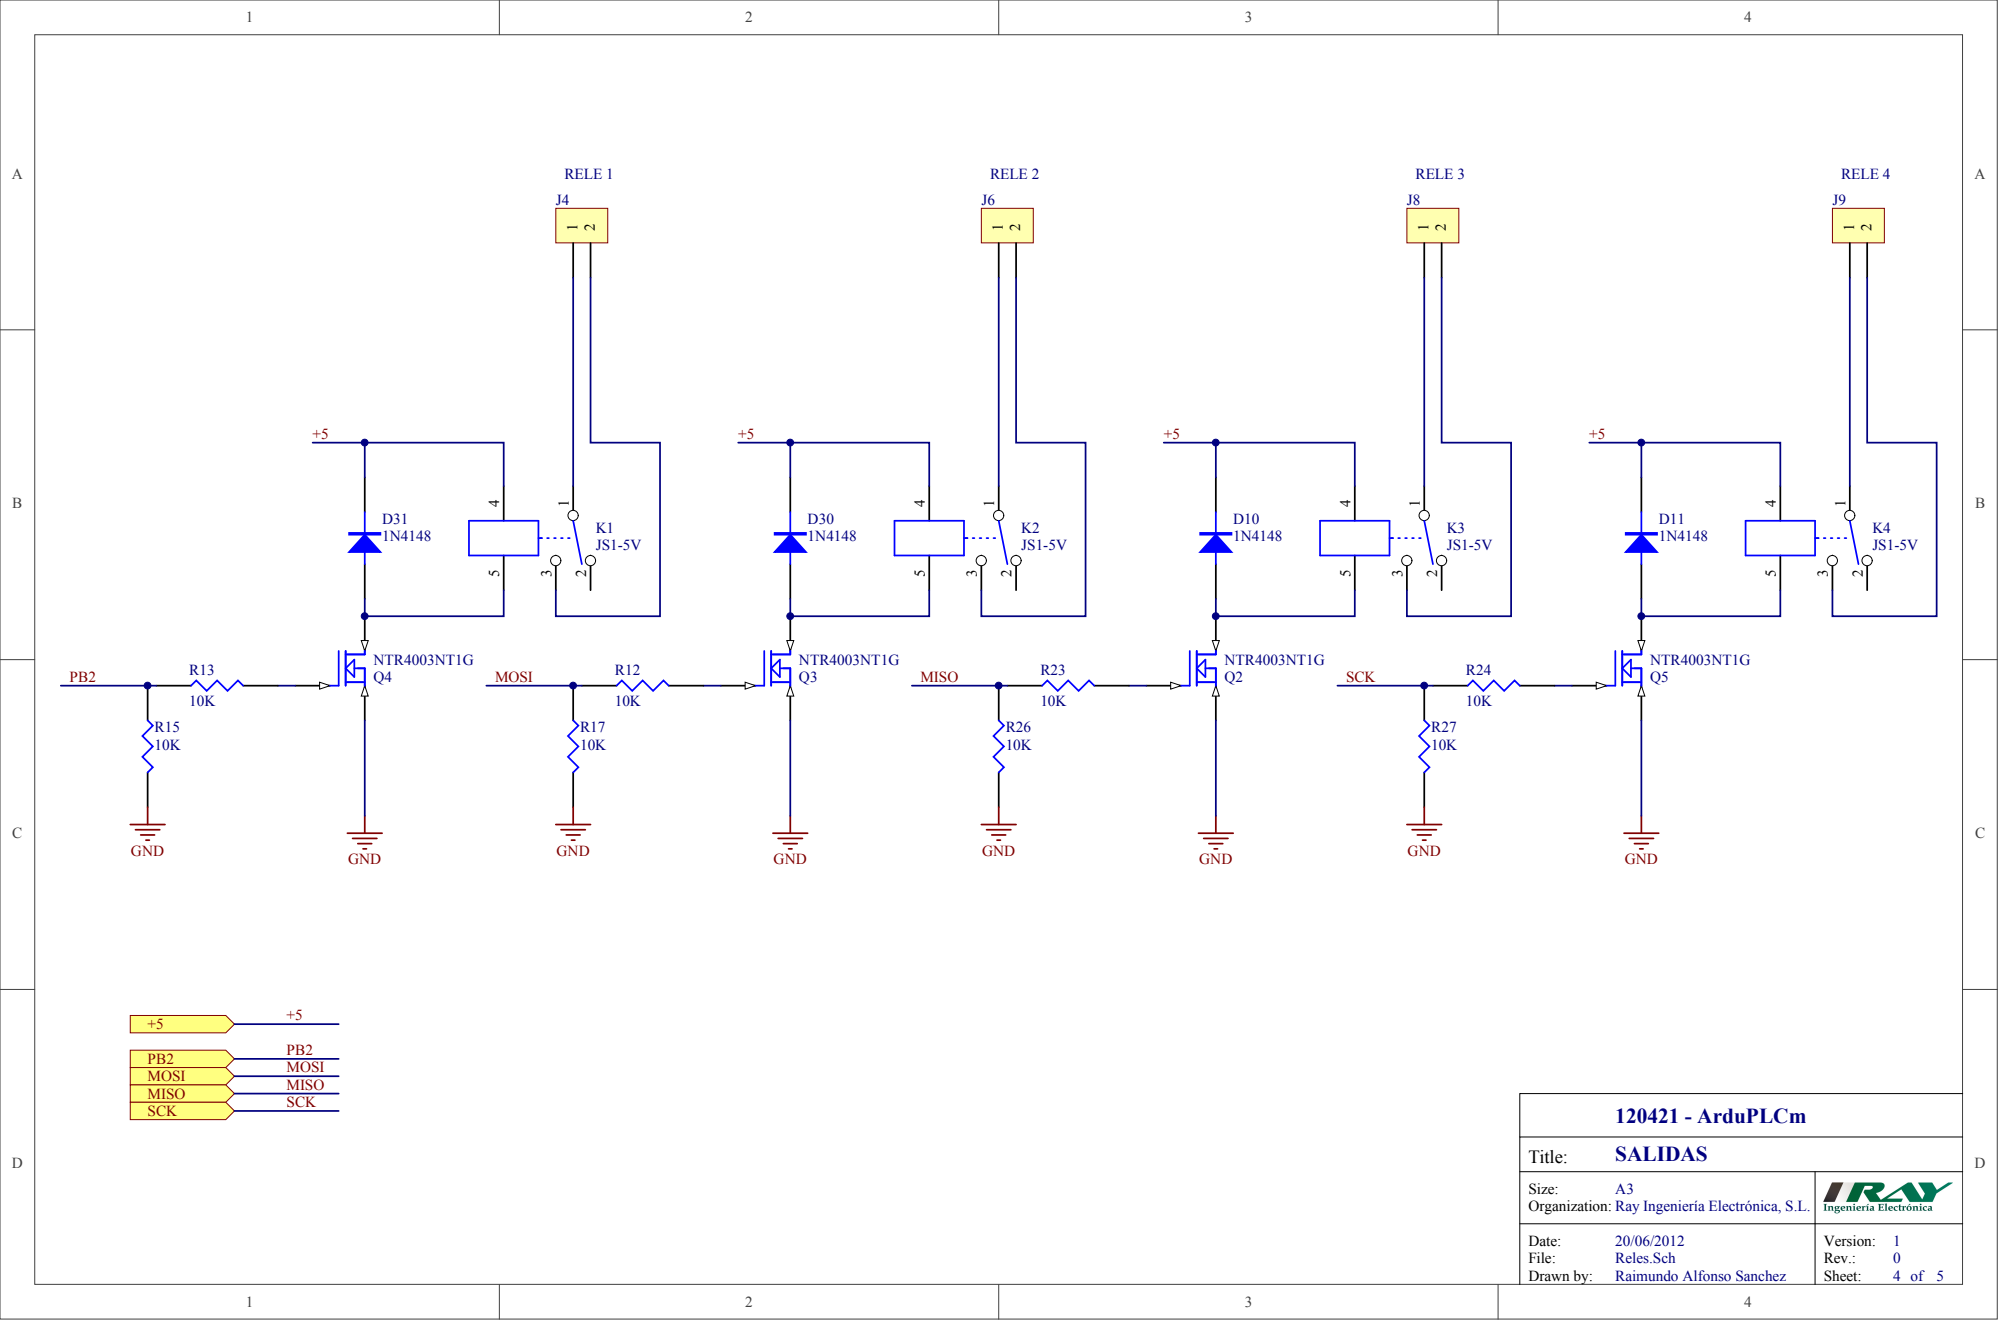
[picture p132: page 5]

Size: A3 Organization: Ray Ingeniería Electrónica, S.L .

Date: File: 20/06/2012 Reles.Sch Drawn by : Raimundo Alfonso Sanchez | Version: 1 Rev.: 0 Sheet: 4 of 5

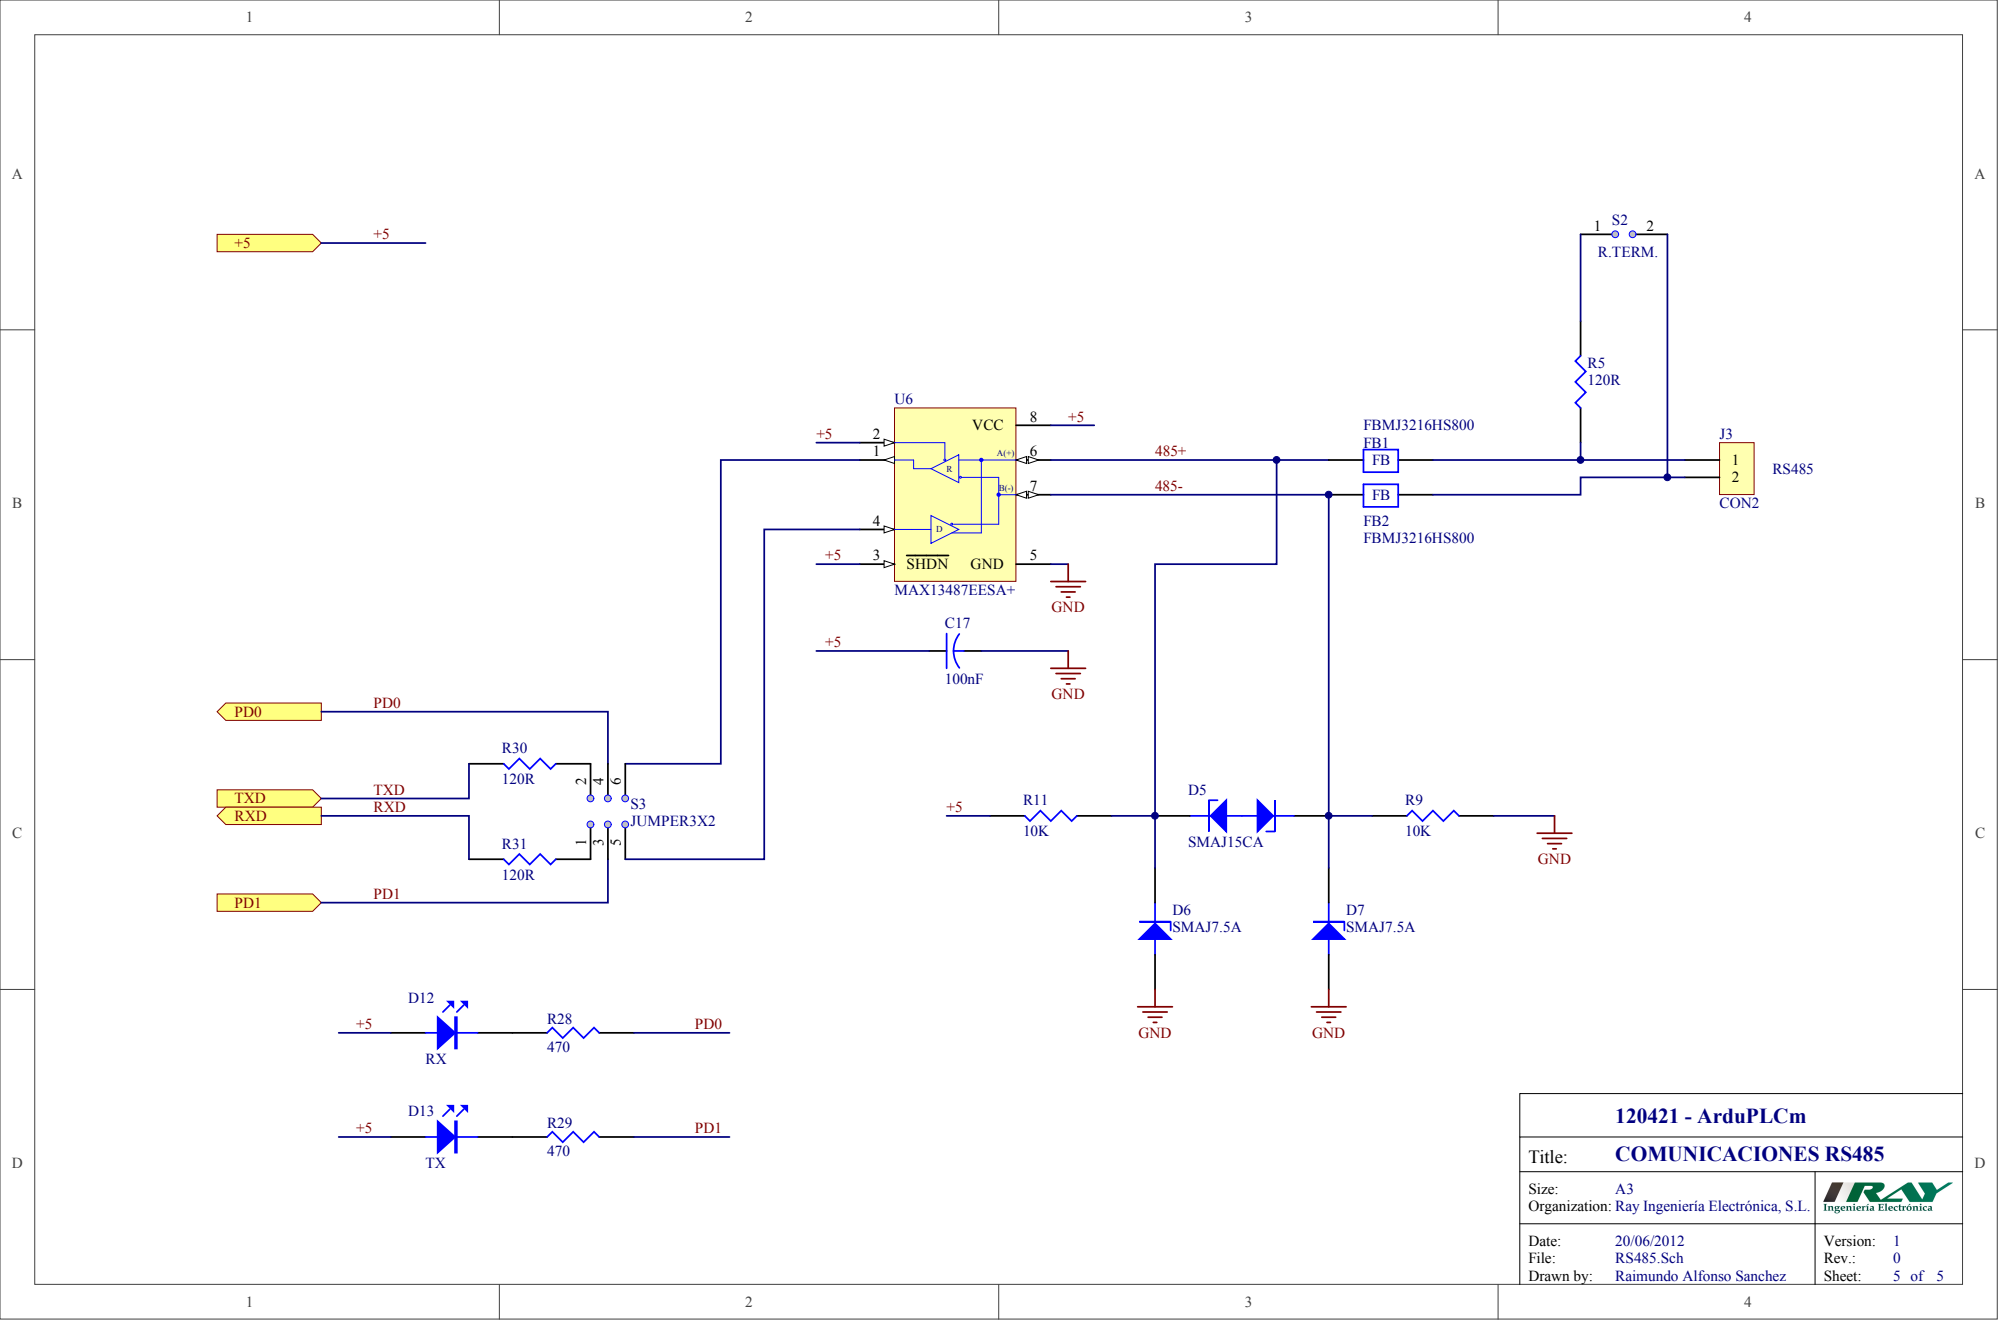
[picture p133: page 6]

Size: A3 Organization: Ray Ingeniería Electrónica, S.L.

Date: 20/06/2012 File: RS485.Sch Drawn by: Raimundo Alfonso Sanchez | Version: 1 Rev.: 0 Sheet: 5 of 5
