raymirabel/ArduPLC/(commit log)

2016-01-14 Actualización
    - Opción de calibración para entradas analógicas
    - Comando para lectura en modo 20mA
2018-03-29 Add files via upload
    AI1...AI6 schematic error definition
